matosmarco/SCDTR-Project/Fase1/Data_treatment/Images/caixa_2.jpg

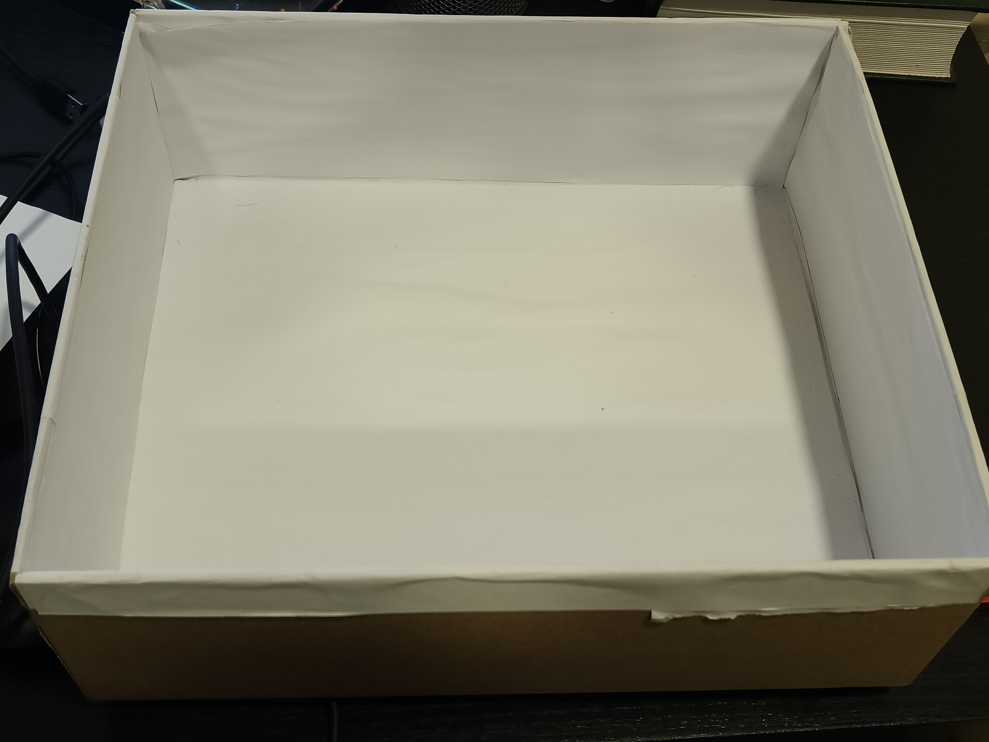
Fase1/Data_treatment/Images/caixa_2.jpg
