matosmarco/SCDTR-Project/Fase1/Data_treatment/Images/IMG20260316221124.jpg

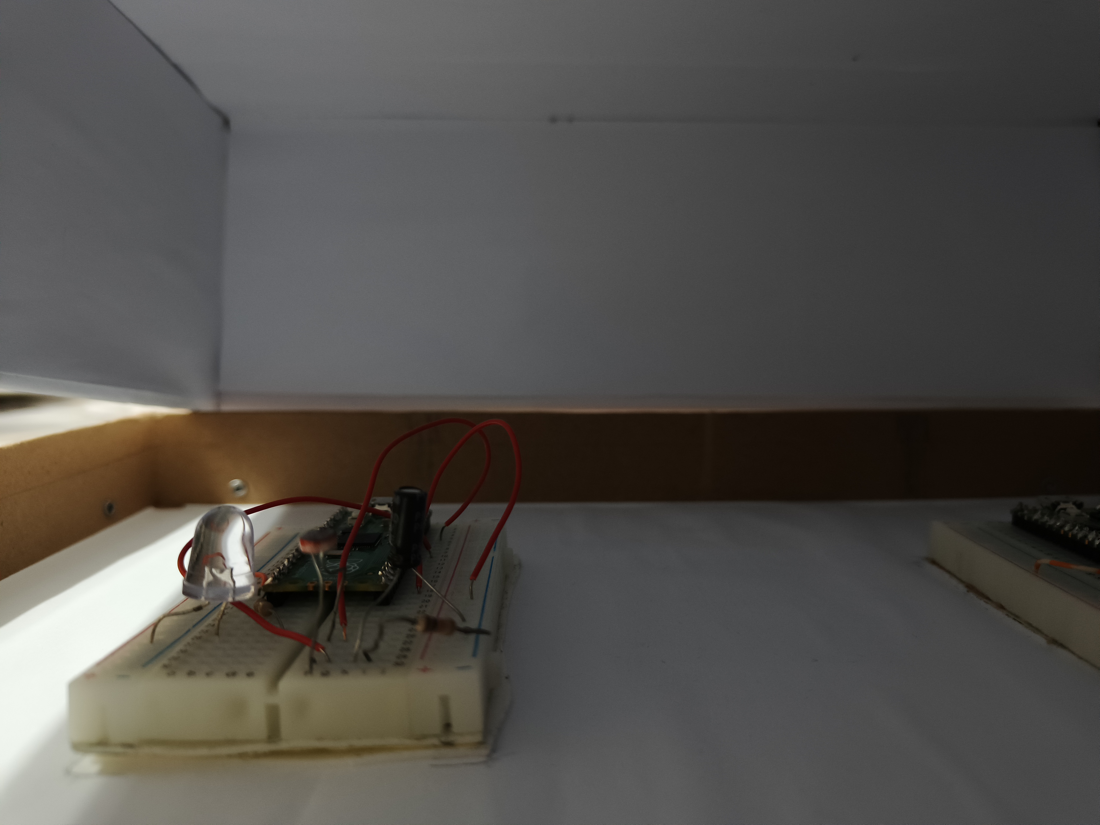
Fase1/Data_treatment/Images/IMG20260316221124.jpg
