matosmarco/SCDTR-Project/Fase1/Data_treatment/Images/stair.pdf

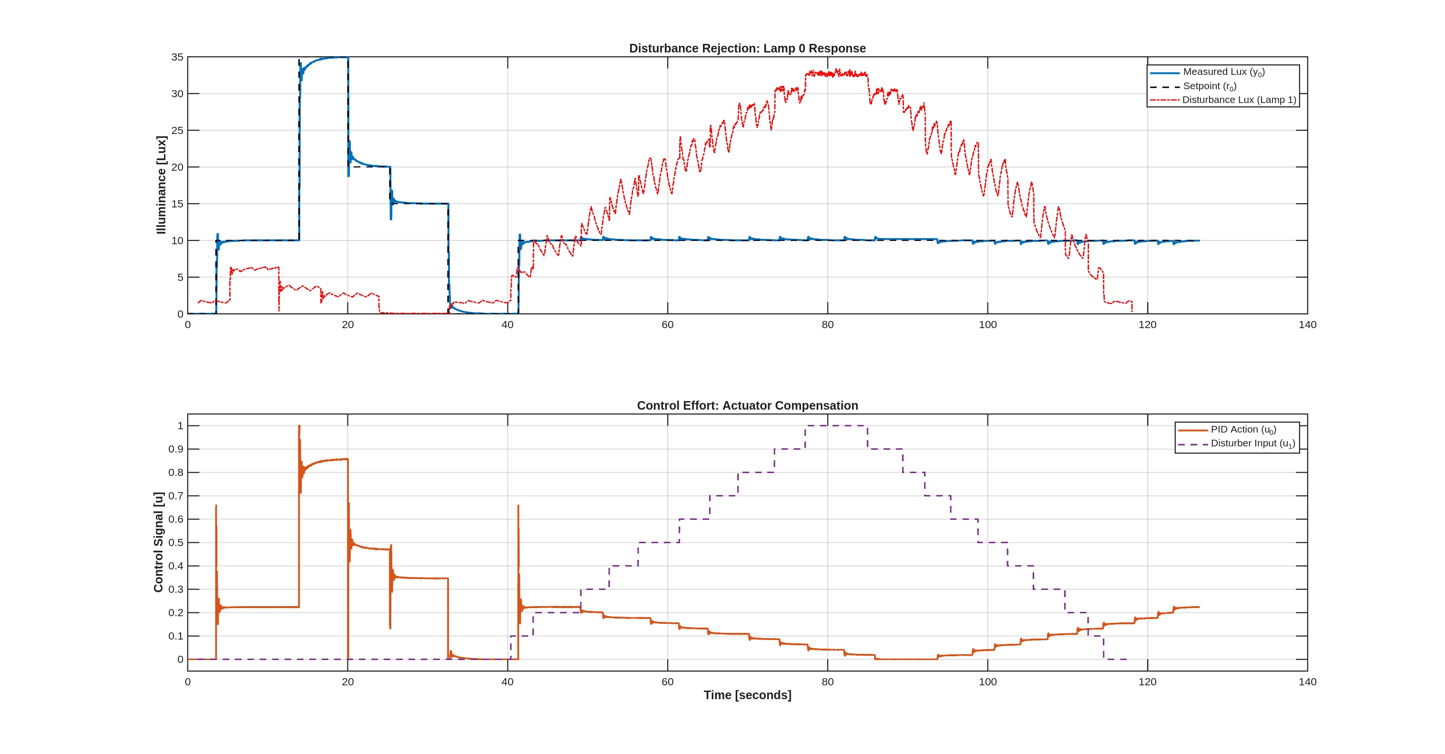
[picture p8: page 1]
