matosmarco/SCDTR-Project/Fase1/Data_treatment/Images/non_linear.pdf

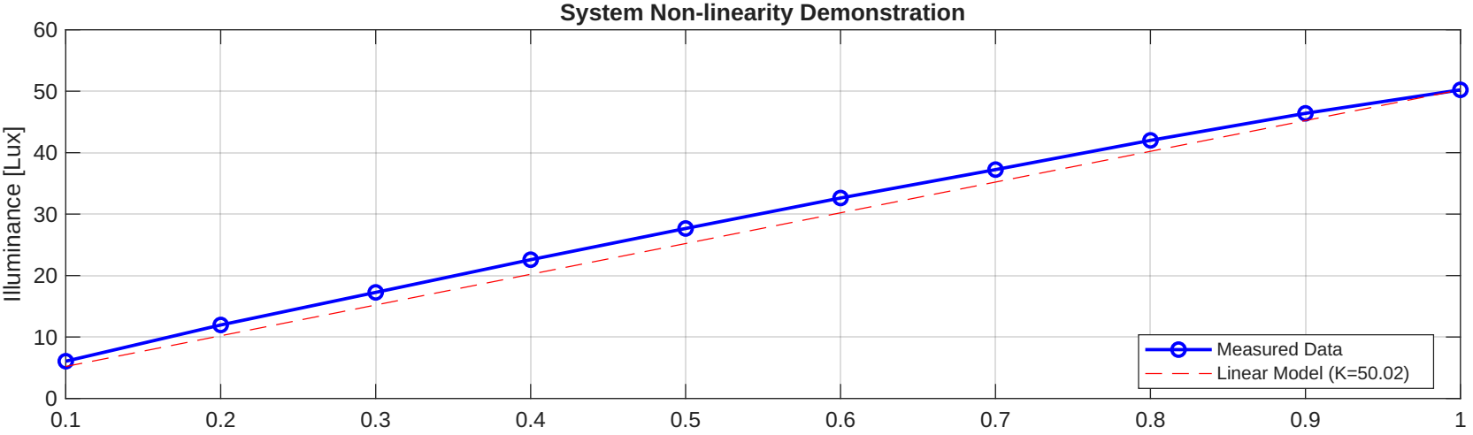
[picture p9: figure]
Illu; min; System Non-linearity Demonstration; Measured Data Linear Model (K=50.02)
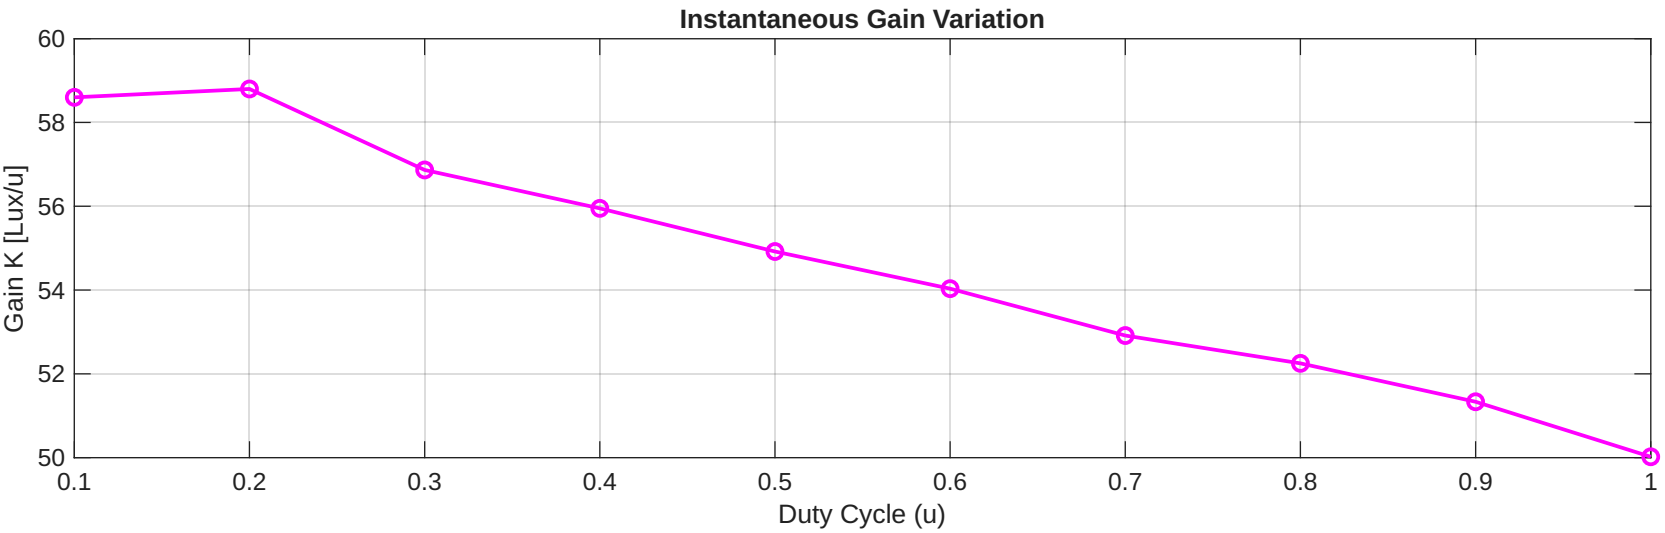
[picture p10: figure]
Duty Cycle (u); ain; Instantaneous Gain Variation
