matosmarco/SCDTR-Project/Fase1/Data_treatment/calib_m.png

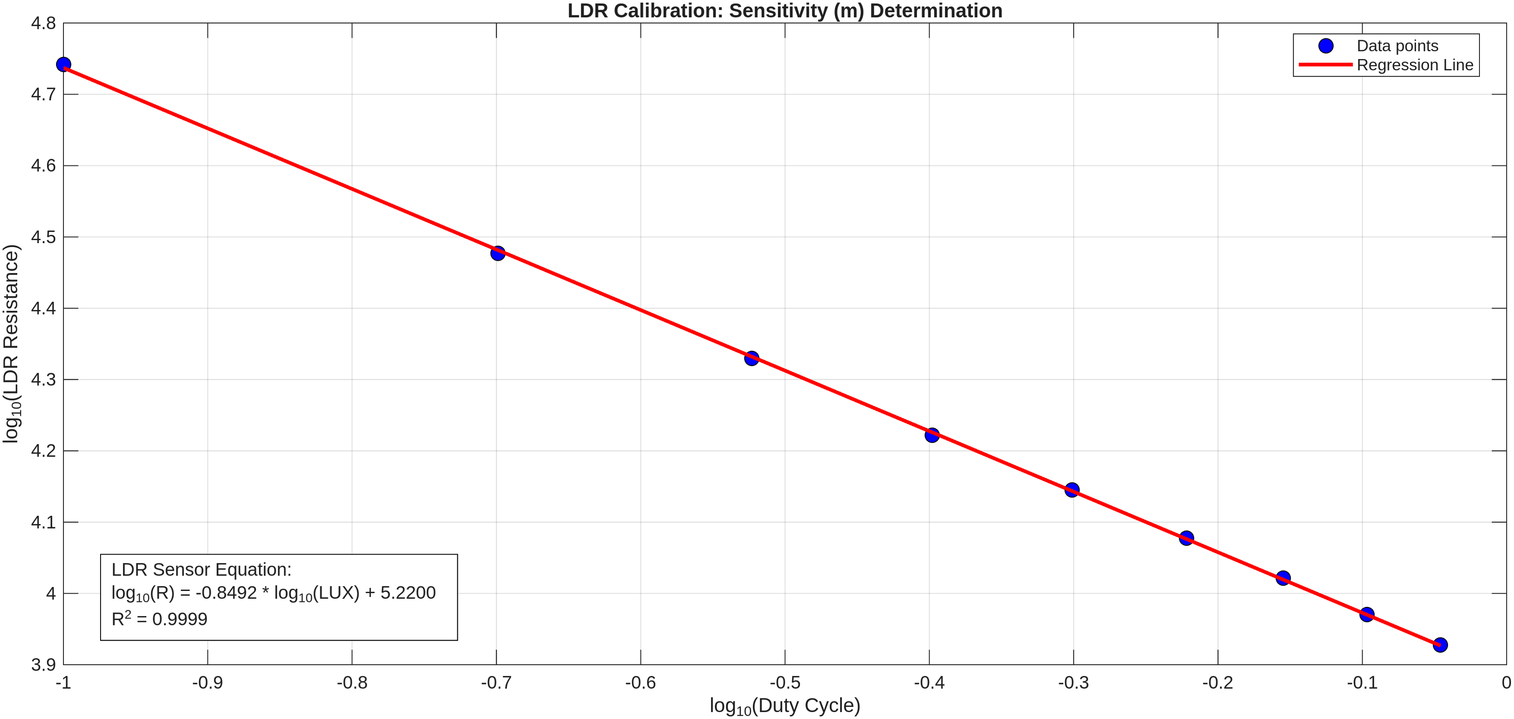
Fase1/Data_treatment/calib_m.png
