matosmarco/SCDTR-Project/Fase1/Data_treatment/comparison/final_kp_comparison.png

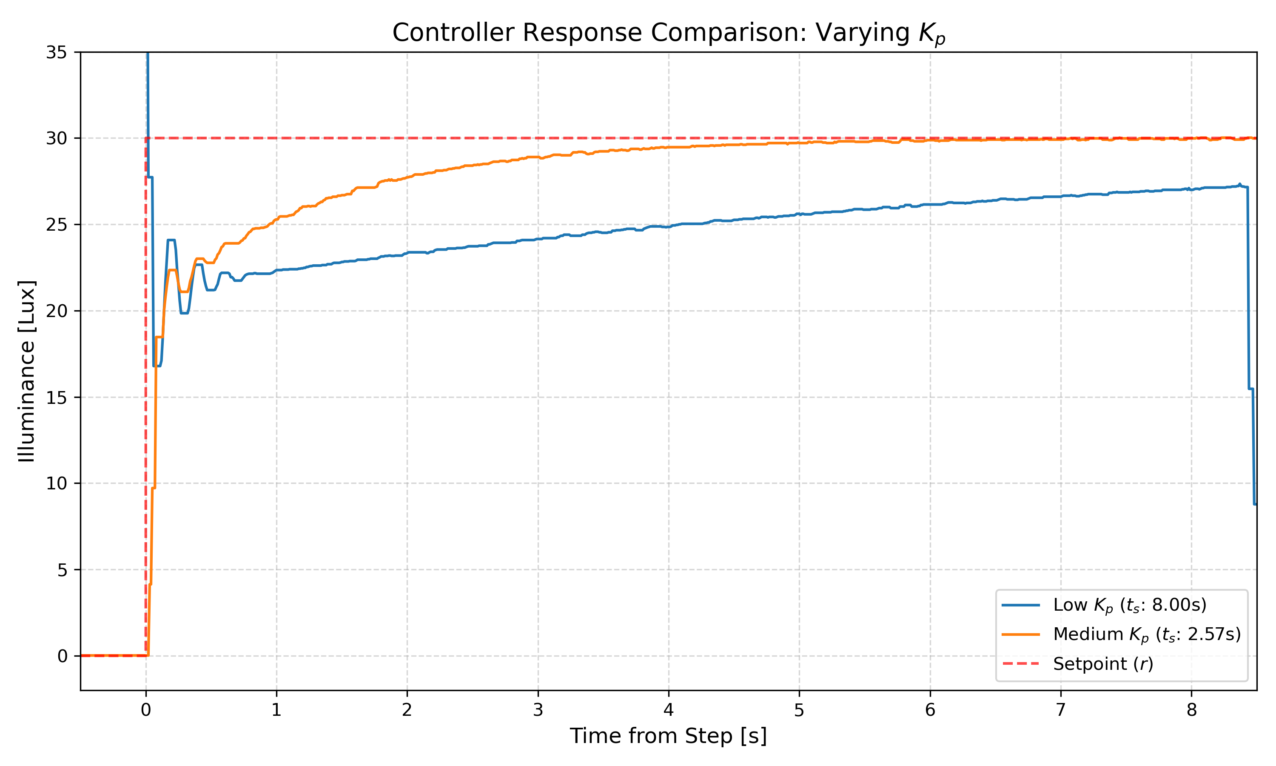
Fase1/Data_treatment/comparison/final_kp_comparison.png
