matosmarco/SCDTR-Project/Fase1/Data_treatment/comparison/setpoint_weighting_comparison.png

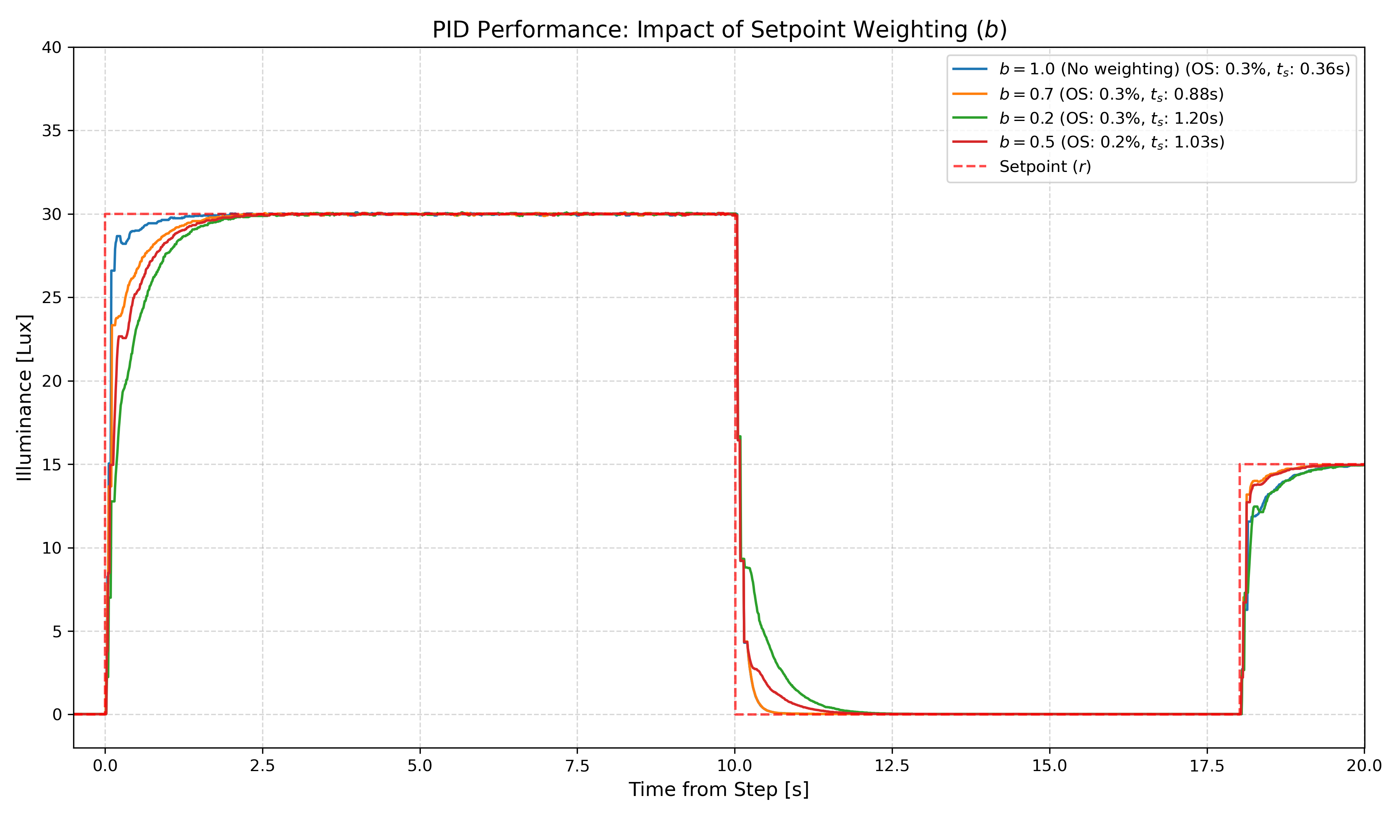
Fase1/Data_treatment/comparison/setpoint_weighting_comparison.png
