matosmarco/SCDTR-Project/Fase1/Data_treatment/comparison/vairos_ki.png

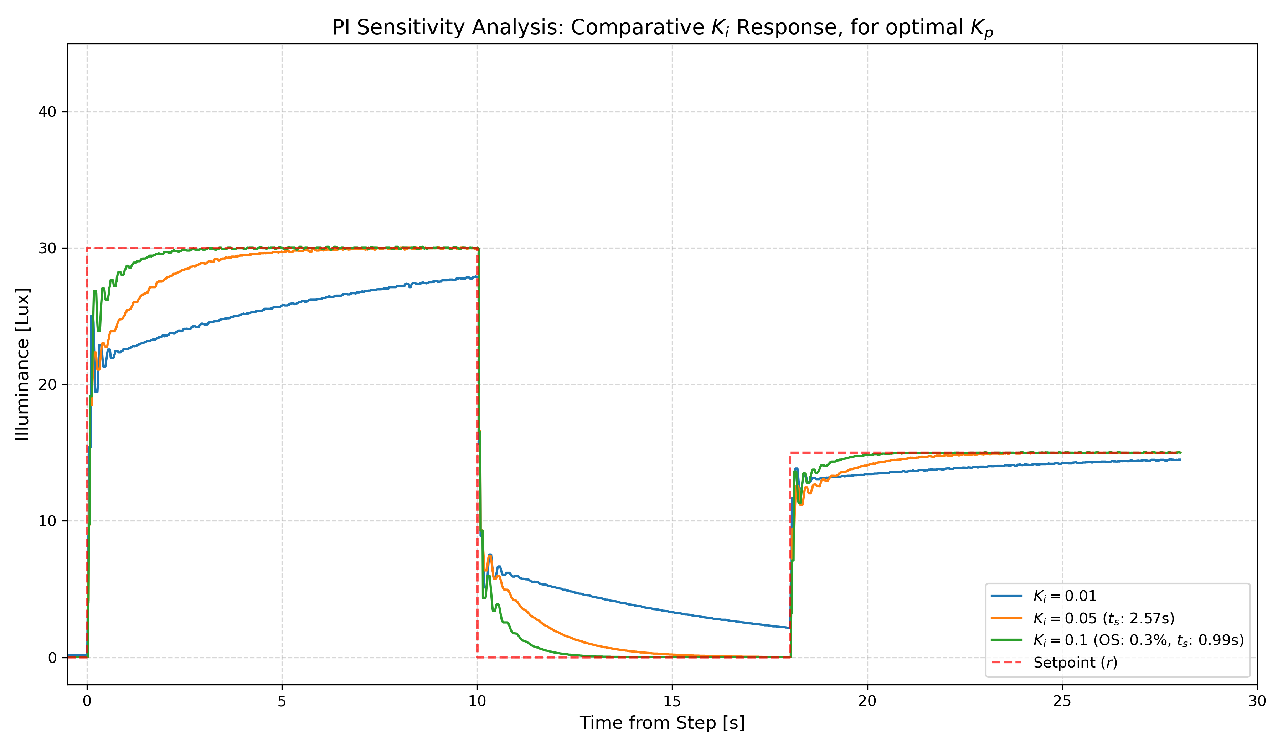
Fase1/Data_treatment/comparison/vairos_ki.png
