matosmarco/SCDTR-Project/Fase1/Data_treatment/comparison/varios_kp.png

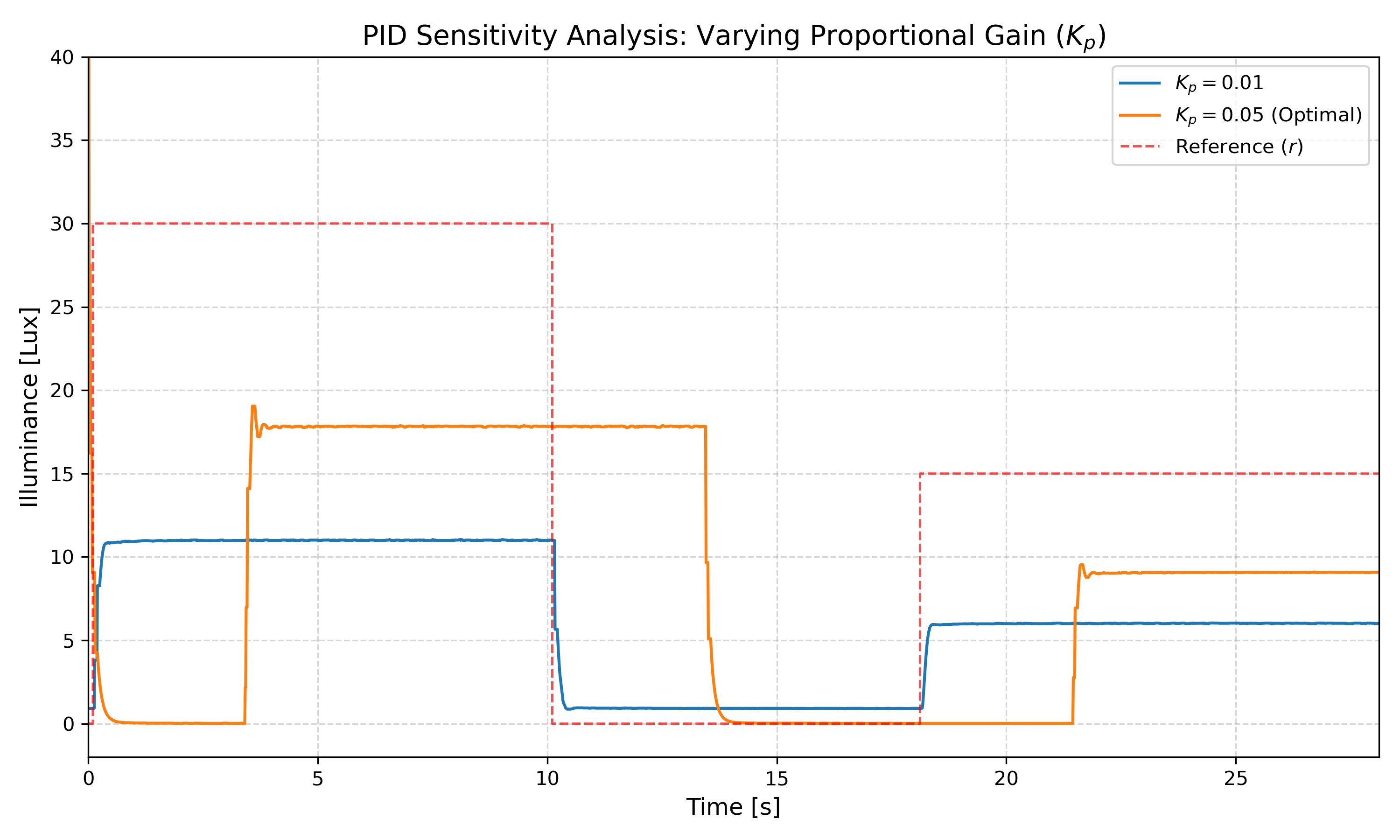
Fase1/Data_treatment/comparison/varios_kp.png
