matosmarco/SCDTR-Project/Fase1/Data_treatment/Images/caixa_1.jpg

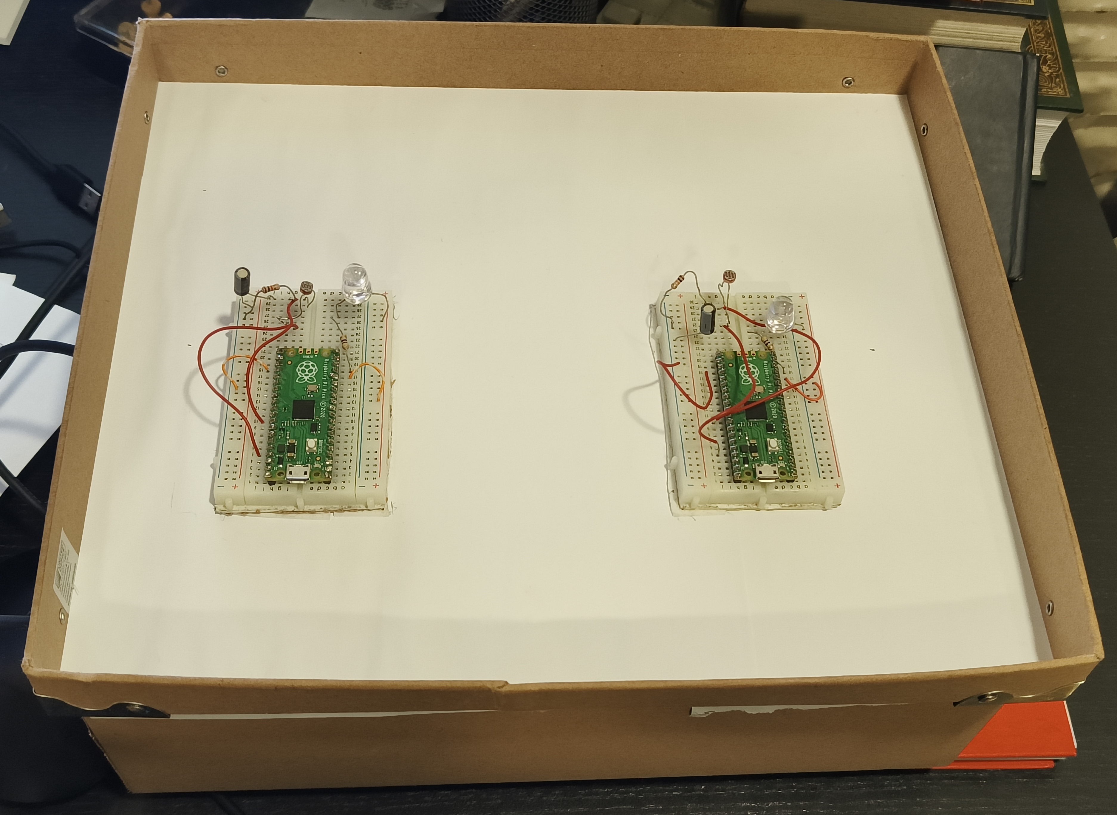
Fase1/Data_treatment/Images/caixa_1.jpg
