matosmarco/SCDTR-Project/Fase1/Data_treatment/Images/caixa_4.jpg

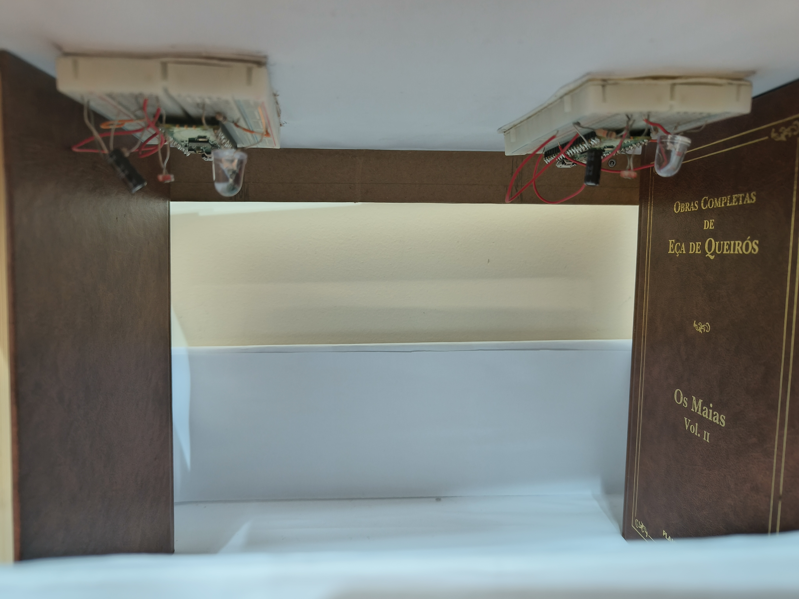
Fase1/Data_treatment/Images/caixa_4.jpg
