matosmarco/SCDTR-Project/Fase1/Data_treatment/Images/Luminaire positions.jpg

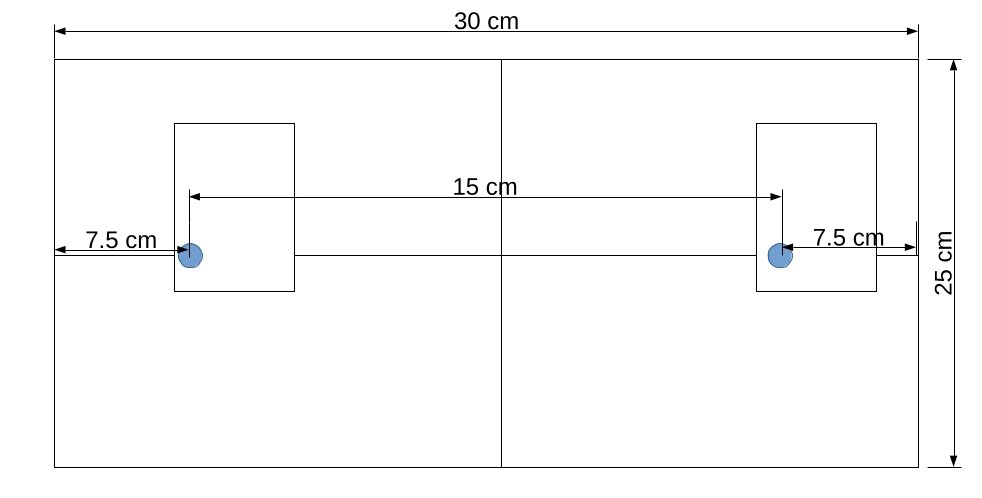
Fase1/Data_treatment/Images/Luminaire positions.jpg
