matosmarco/SCDTR-Project/Fase1/Data_treatment/Images/table1.png

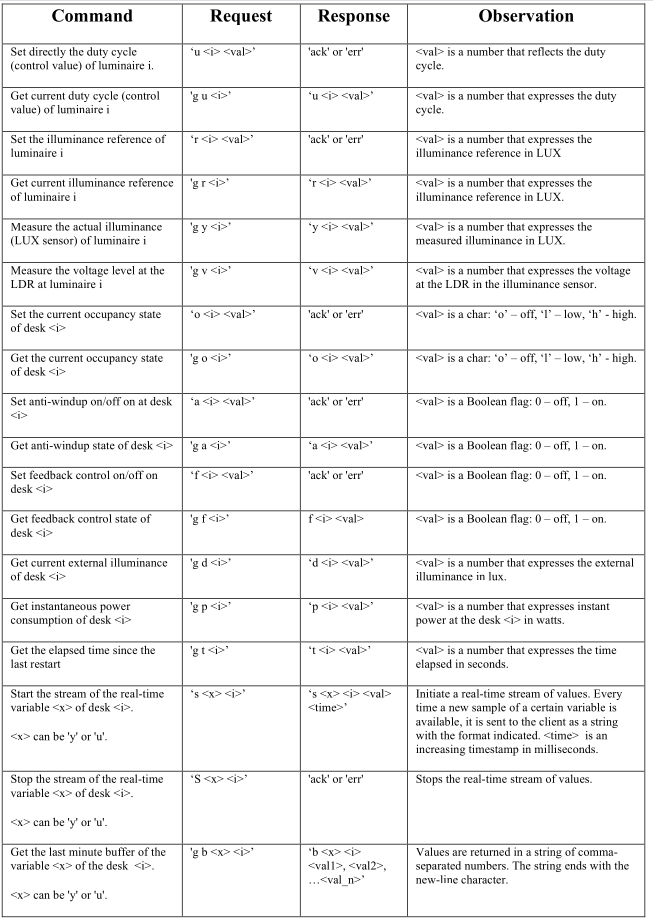
Fase1/Data_treatment/Images/table1.png
