matosmarco/SCDTR-Project/Fase1/Data_treatment/Images/table2.png

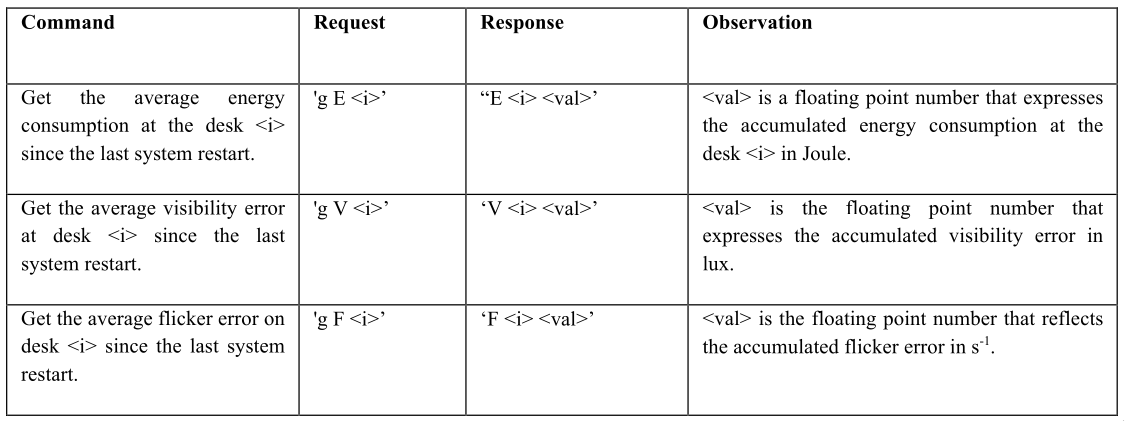
Fase1/Data_treatment/Images/table2.png
