matosmarco/SCDTR-Project/Fase1/Data_treatment/simulator.png

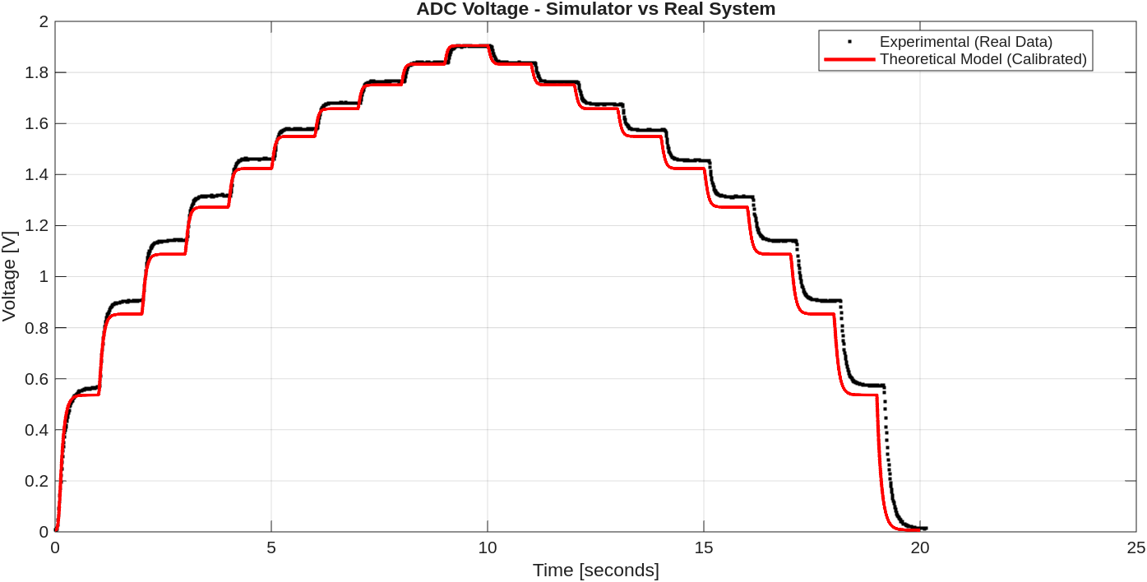
Fase1/Data_treatment/simulator.png
