matosmarco/SCDTR-Project/Fase1/Data_treatment/tau.png

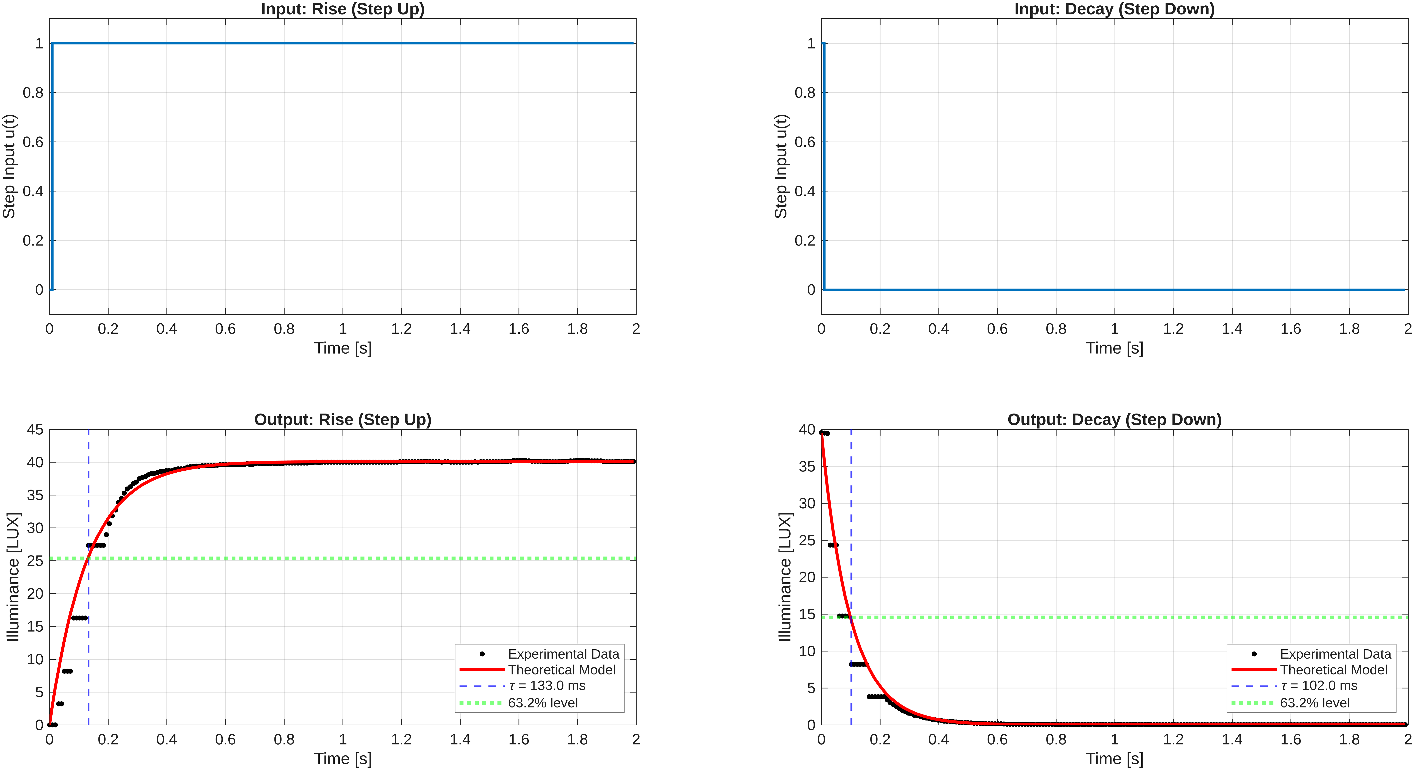
Fase1/Data_treatment/tau.png
