matosmarco/SCDTR-Project/Project/Info/LAB1-FIRST-STEPS.pdf

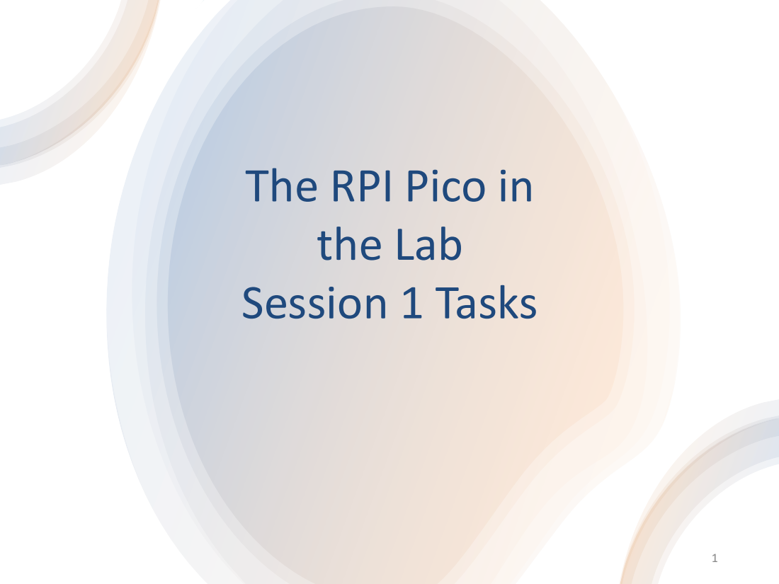
[picture p23: page 1]

The RPI Pico in
the Lab
Session 1 Tasks

# Session 1 Lab Tasks Install Software

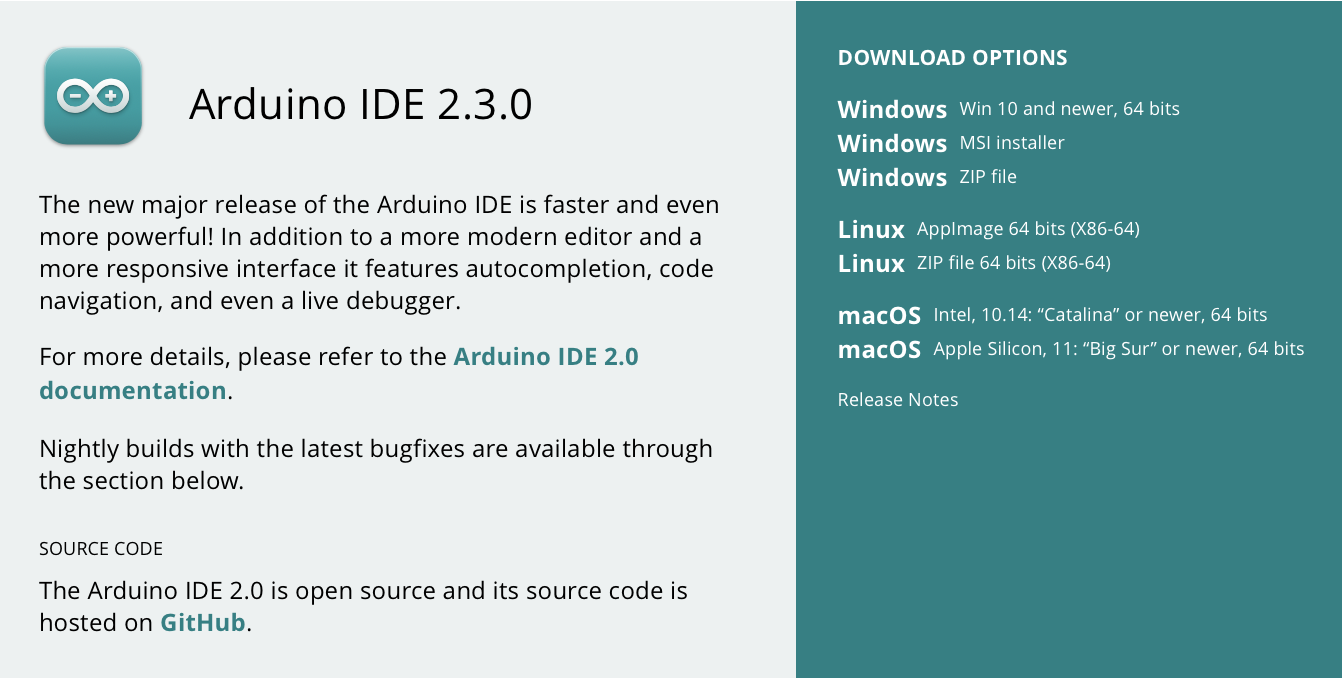
[picture p24: figure]

## Arduino IDE https://www.arduino.cc/en/software

## Arduino-core for RPI Pico Installation https://arduino-pico.readthedocs.io/en/latest/

# Session 1 Lab Tasks

# Write your first RPI pico program

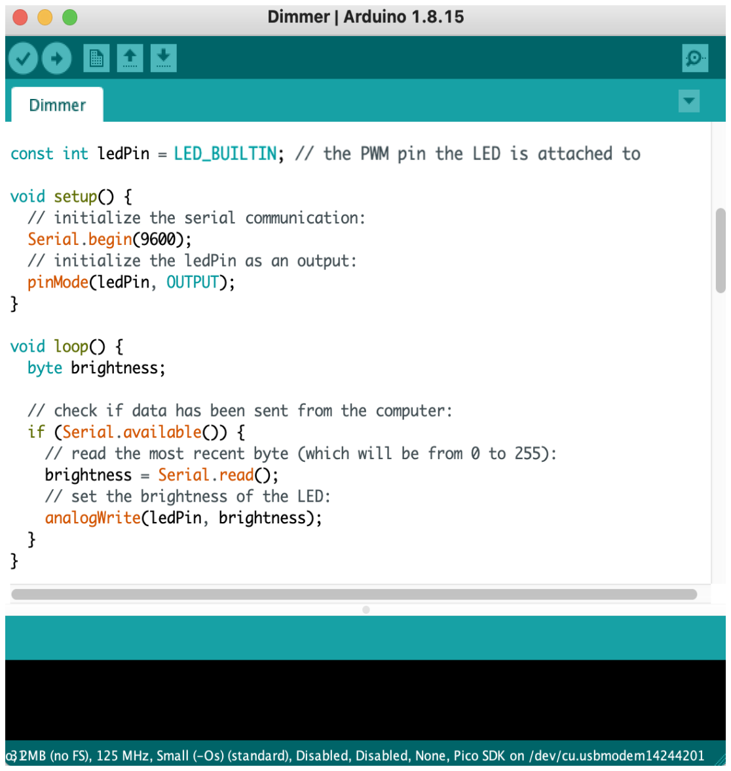
[picture p25: figure]

# - Look at menu “File/Examples”. Try out some sketches that use serial comms between PC and pico to become familiar with the programming environment, e.g. Dimmer

and Temperature.

# Session 1 Lab Tasks Load Firmware

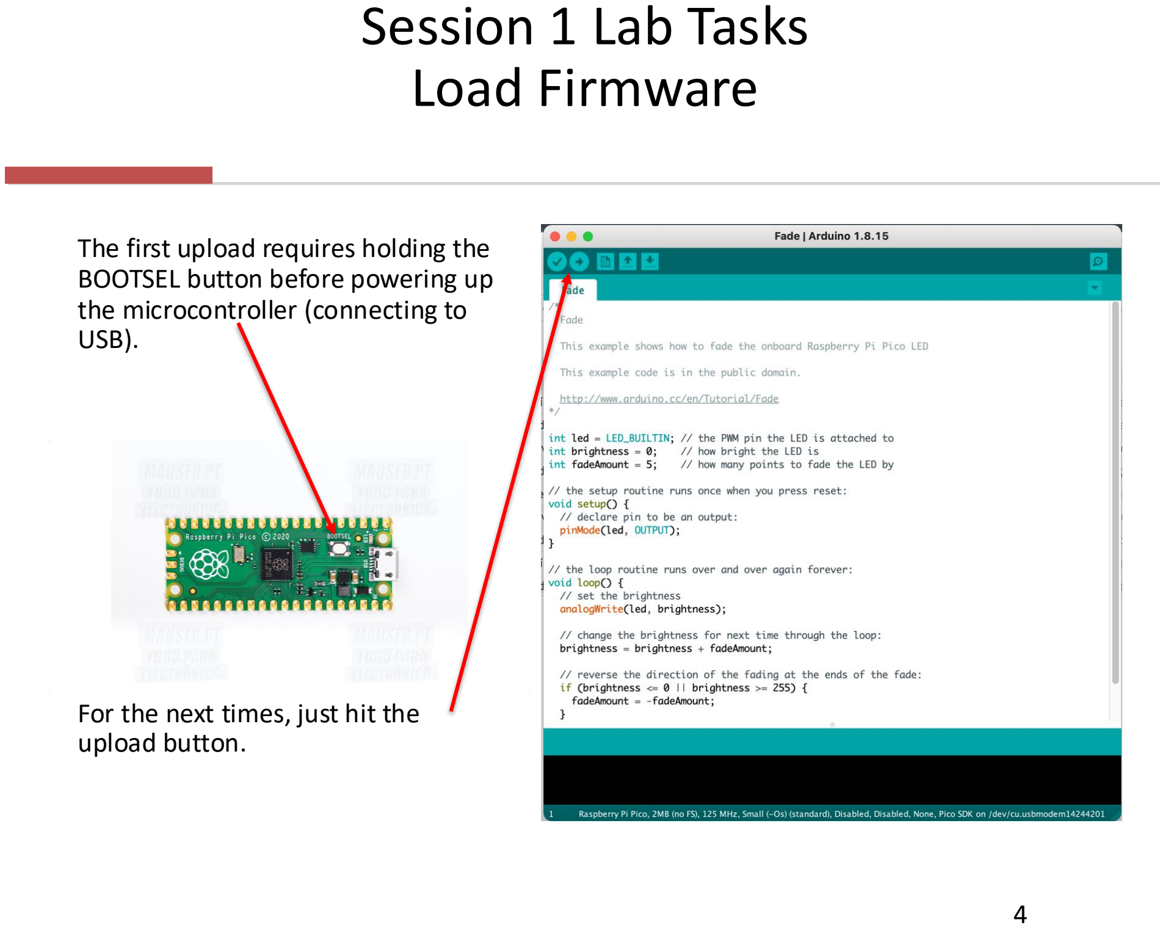
[picture p26: page 4]

## The first upload requires holding the BOOTSEL button before powering up the microcontroller (connecting to

USB).

## For the next times, just hit the

upload button.

# Week 1 Lab Tasks

# Serial USB Interface

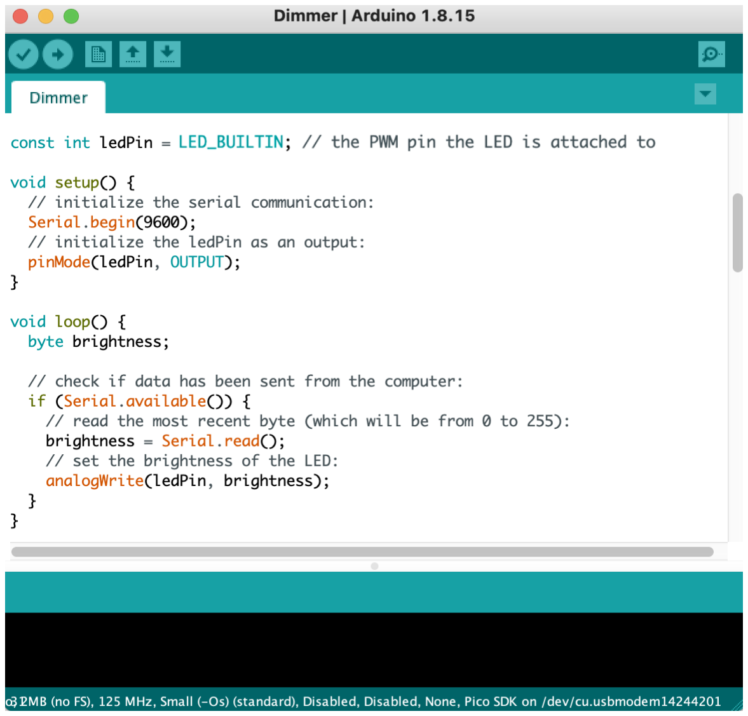
[picture p27: figure]

# - Look at some exemples that use serial communication between PC and pico, e.g. Dimmer

and Temperature.

# Session 1 Lab Tasks

# Serial USB Interface

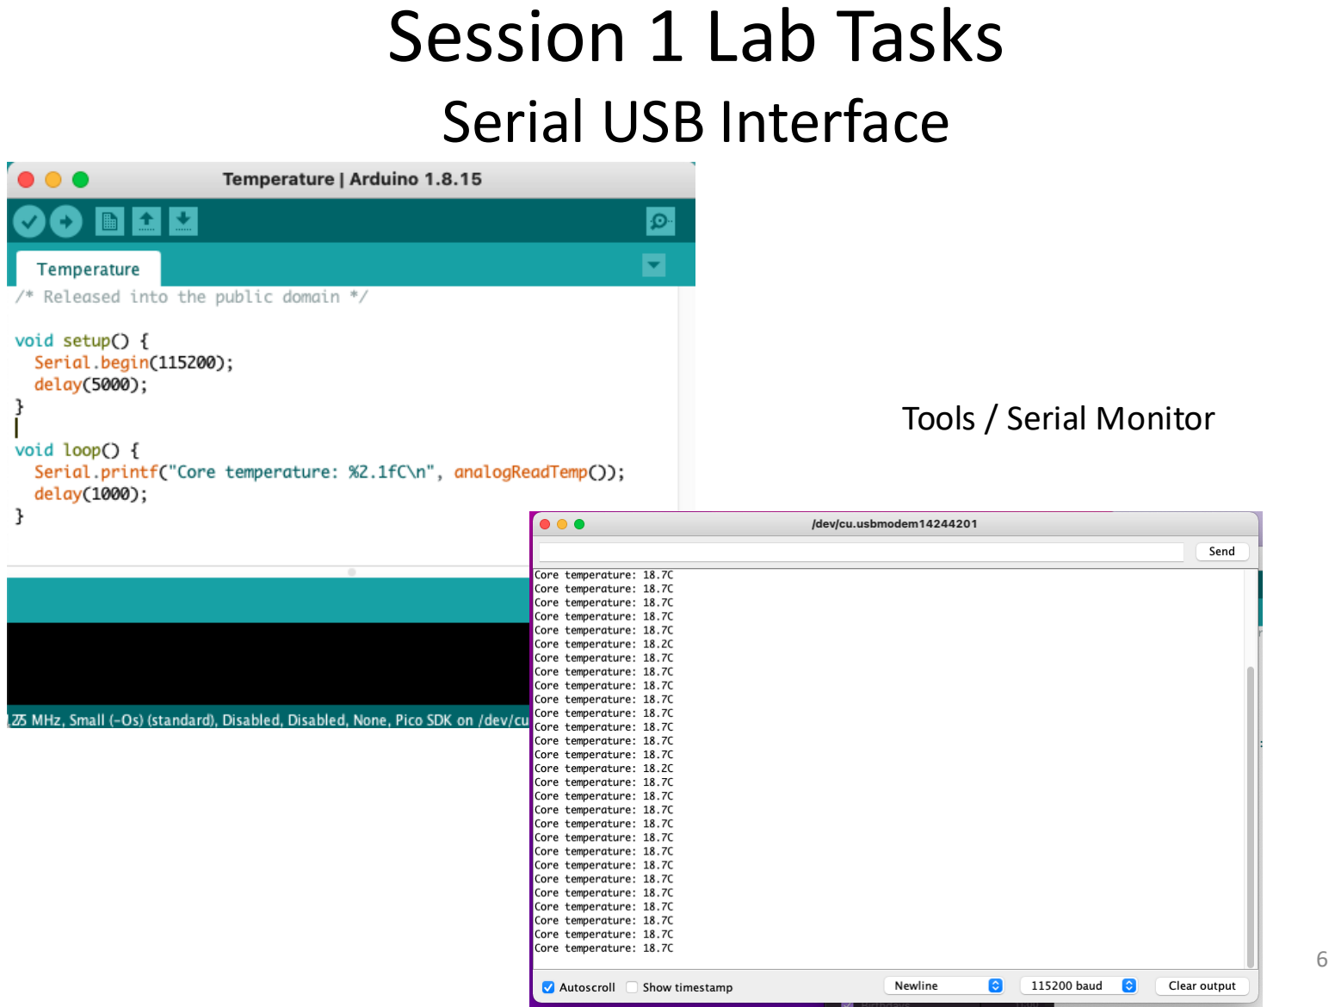
[picture p28: page 6]

# Tools / Serial Monitor

# Session Lab Tasks

# Prepare the Pico

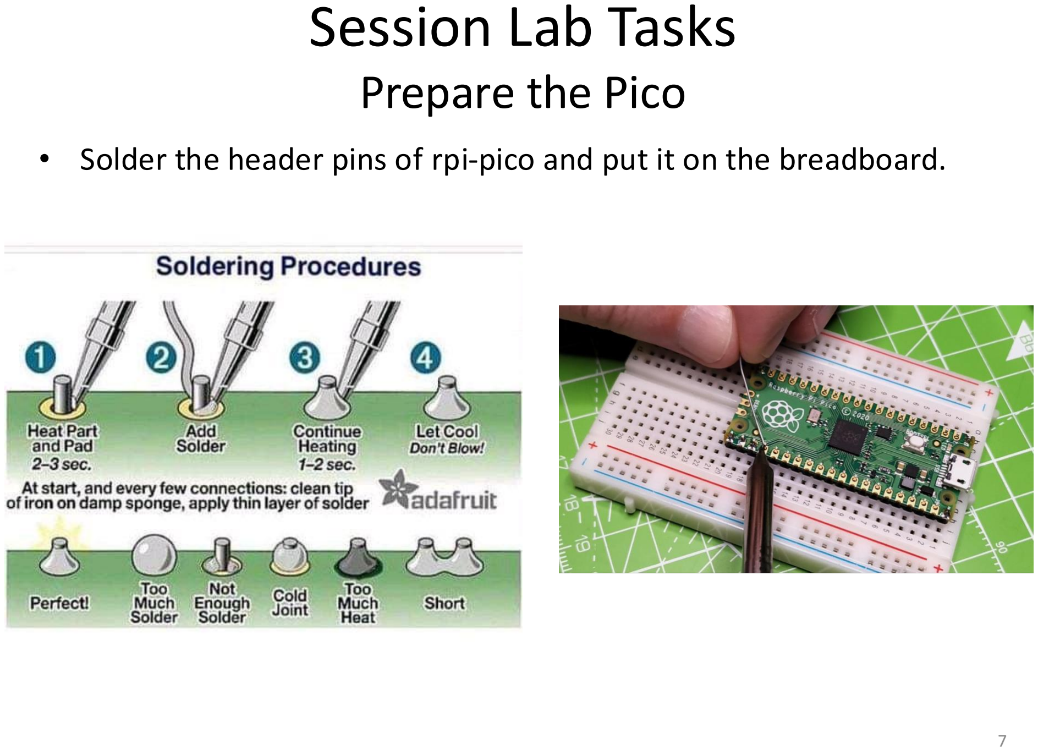
[picture p29: page 7]

- Solder the header pins of rpi-pico and put it on the breadboard.

# Session 1 Lab Tasks

# Assemble the Breadboard Components

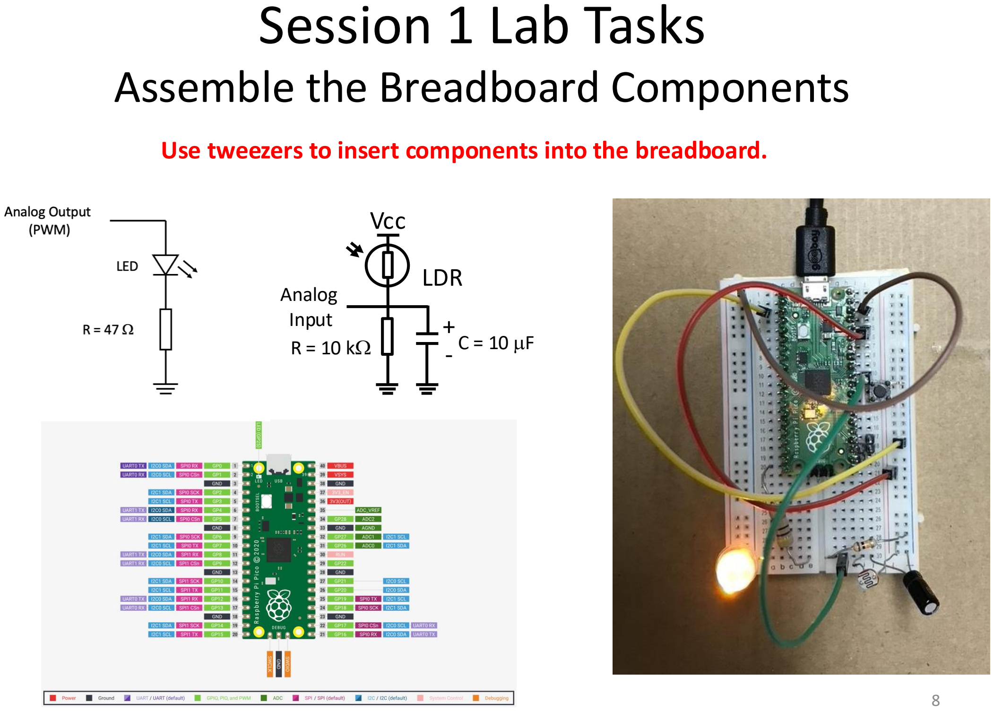
[picture p30: page 8]

# Vcc

# LDR

## Analog

Input | +
R = 10 kΩ | C = 10 µF

Use tweezers to insert components into the breadboard.

# Session 1 Lab Tasks

# Basic IO

const int LED_PIN = 15;

const int DAC_RANGE = 4096;

int counter = 0;

void setup() {// the setup function runs once

Serial.begin(115200);

analogReadResolution(12); //default is 10

analogWriteFreq(60000); //60KHz, about max

analogWriteRange(DAC_RANGE); //100% duty cycle

}

void loop() {// the loop function runs cyclically

int read_adc;

analogWrite(LED_PIN, counter); // set led PWM

delay(1); | //delay 1ms

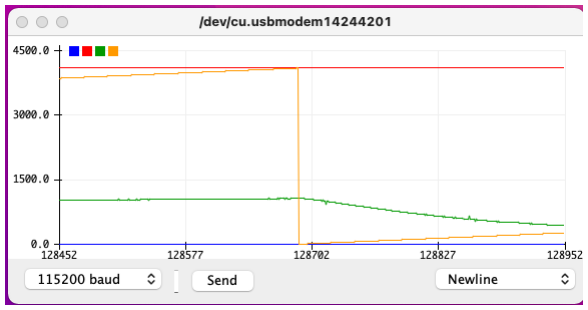
[picture p31: figure]

read_adc = analogRead(A0); // read analog voltage

counter = counter + 1;

if (counter > DAC_RANGE) // if counter saturates

counter = 0; | // reset counter

//format that Serial Plotter likes

Serial.print(0); Serial.print(" ");

Serial.print(DAC_RANGE); Serial.print(" ");

Serial.print(read_adc); Serial.print(" ");

Serial.print(counter); Serial.println();

}

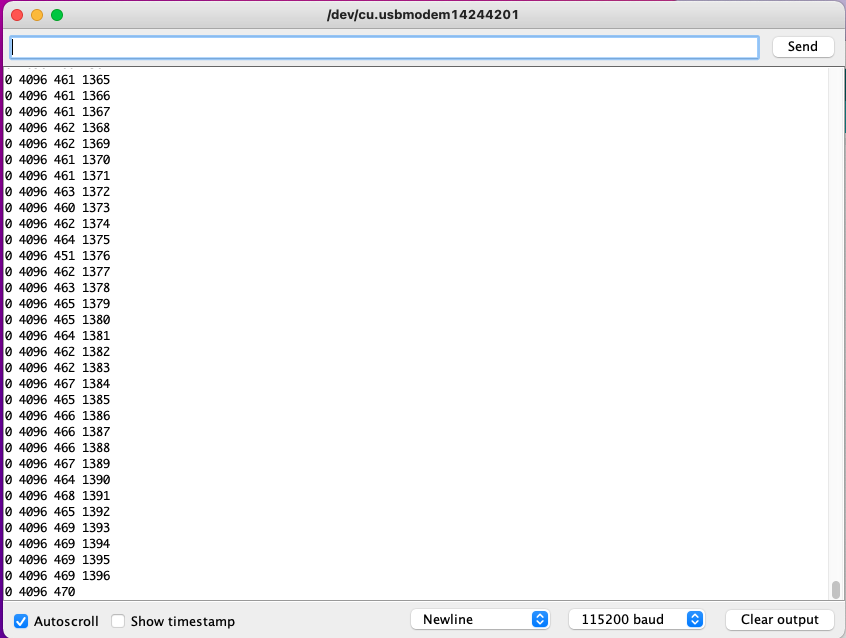
[picture p32: figure]

# Serial Plotter

# Serial Monitor
