matosmarco/SCDTR-Project/Fase1/Data_treatment/PID/results_kp005.txt

s b 0 1.78 0.0413 0.00 207924
s b 0 1.77 0.0416 0.00 207934
s b 0 1.77 0.0416 0.00 207944
s b 0 1.77 0.0416 0.00 207954
s b 0 1.77 0.0416 0.00 207964
s b 0 1.77 0.0416 0.00 207974
s b 0 1.77 0.0416 0.00 207984
s b 0 1.76 0.0419 0.00 207994
s b 0 1.77 0.0416 0.00 208004
s b 0 1.77 0.0416 0.00 208014
s b 0 1.77 0.0416 0.00 208024
s b 0 1.78 0.0413 0.00 208034
s b 0 1.78 0.0413 0.00 208044
s b 0 1.78 0.0410 0.00 208054
s b 0 1.78 0.0410 0.00 208064
s b 0 1.78 0.0413 0.00 208074
s b 0 1.78 0.0413 0.00 208084
s b 0 1.78 0.0413 0.00 208094
s b 0 1.78 0.0413 0.00 208104
s b 0 1.78 0.0413 0.00 208114
s b 0 1.78 0.0413 0.00 208124
s b 0 1.77 0.0416 0.00 208134
s b 0 1.77 0.0416 0.00 208144
s b 0 1.76 0.0419 0.00 208154
s b 0 1.76 0.0419 0.00 208164
s b 0 1.76 0.0419 0.00 208174
s b 0 1.76 0.0419 0.00 208184
s b 0 1.76 0.0419 0.00 208194
s b 0 1.76 0.0422 0.00 208204
s b 0 1.76 0.0422 0.00 208214
s b 0 1.76 0.0422 0.00 208224
s b 0 1.76 0.0419 0.00 208234
s b 0 1.76 0.0419 0.00 208244
s b 0 1.77 0.0416 0.00 208254
s b 0 1.77 0.0416 0.00 208264
s b 0 1.78 0.0413 0.00 208274
s b 0 1.78 0.0413 0.00 208284
s b 0 1.78 0.0413 0.00 208294
s b 0 1.78 0.0410 0.00 208304
s b 0 1.78 0.0410 0.00 208314
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
ack
s b 0 1.78 0.5413 10.00 214234
s b 0 1.78 0.5413 10.00 214244
s b 0 1.78 0.5413 10.00 214254
s b 0 4.91 0.3846 10.00 214264
s b 0 4.91 0.3846 10.00 214274
s b 0 4.91 0.3846 10.00 214284
s b 0 4.91 0.3846 10.00 214294
s b 0 4.91 0.3846 10.00 214304
s b 0 9.34 0.1629 10.00 214314
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
s b 0 8.84 0.1881 10.00 232734
s b 0 8.79 0.1906 10.00 232744
s b 0 8.66 0.1969 10.00 232754
s b 0 8.61 0.1994 10.00 232764
s b 0 8.55 0.2026 10.00 232774
s b 0 8.45 0.2075 10.00 232784
s b 0 8.45 0.2075 10.00 232794
s b 0 8.44 0.2081 10.00 232804
s b 0 8.43 0.2087 10.00 232814
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
