matosmarco/SCDTR-Project/Fase1/Data_treatment/Images/bumpless.pdf

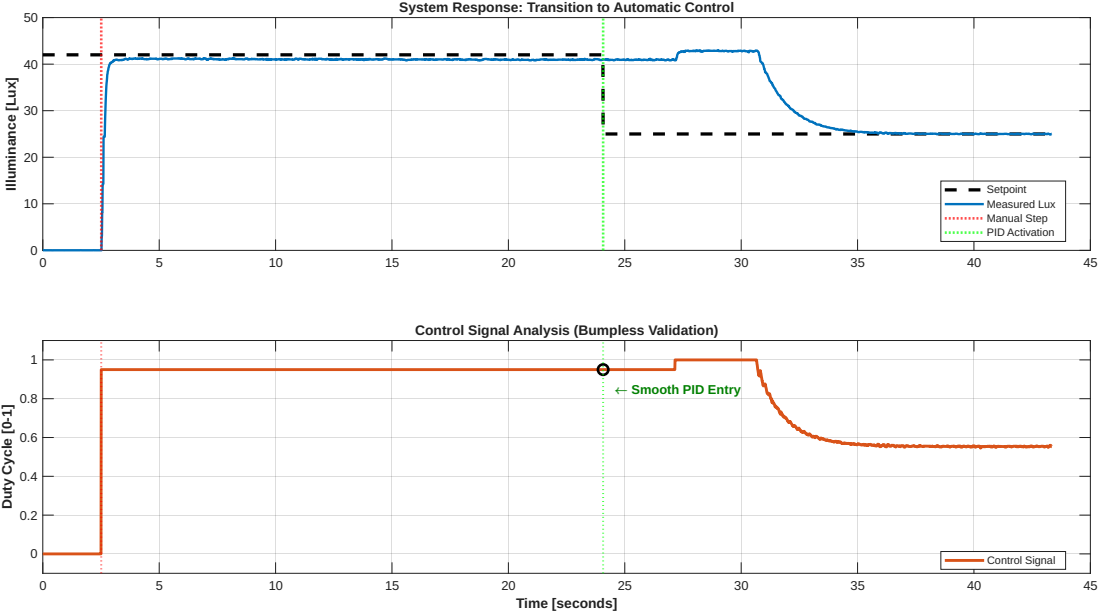
[picture p34: page 1]
Illuminance [Lux]; Duty Cycle [0-1]; ol Sig

S e t p oin t M e a s u r e d L u x

M a n u al S t e p PID A c tiv a tio n
