matosmarco/SCDTR-Project/Fase1/Data_treatment/Images/disturbance_more controled.pdf

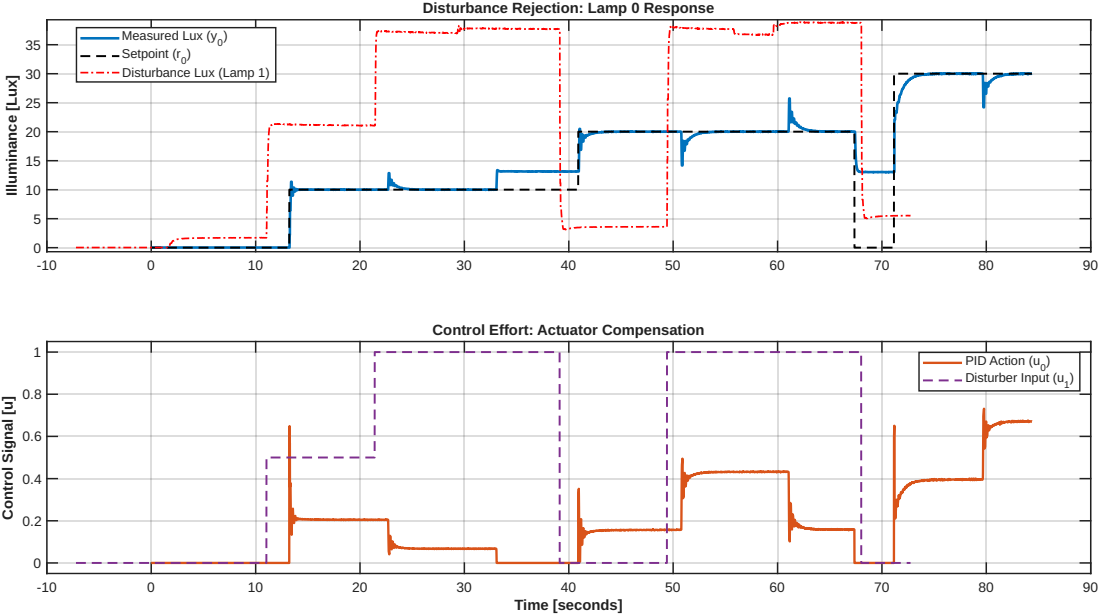
[picture p35: page 1]
Illuminance [Lux]; Control Signal [u]; PID; tio; Dis

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
