matosmarco/SCDTR-Project/Fase1/Data_treatment/Images/state_switching.pdf

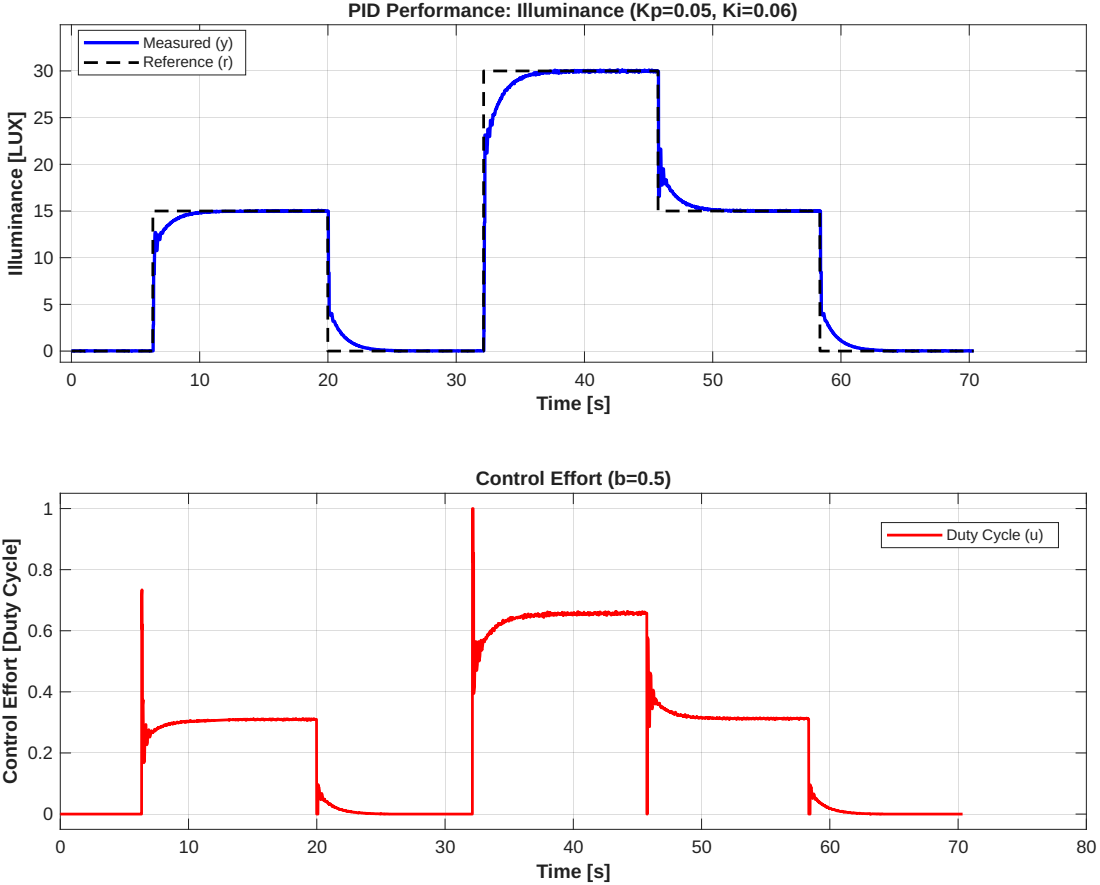
[picture p37: page 1]
Time [s]; Illu; min; Measured (y) Reference (r); ntrol Effort [D; uty; cle]; Control Effort (b=0.5); Duty Cycle (u)

PID Performance: Illuminance (Kp=0.05, Ki=0.06)
