matosmarco/SCDTR-Project/Fase1/Data_treatment/Images/disturbance_not_measured.pdf

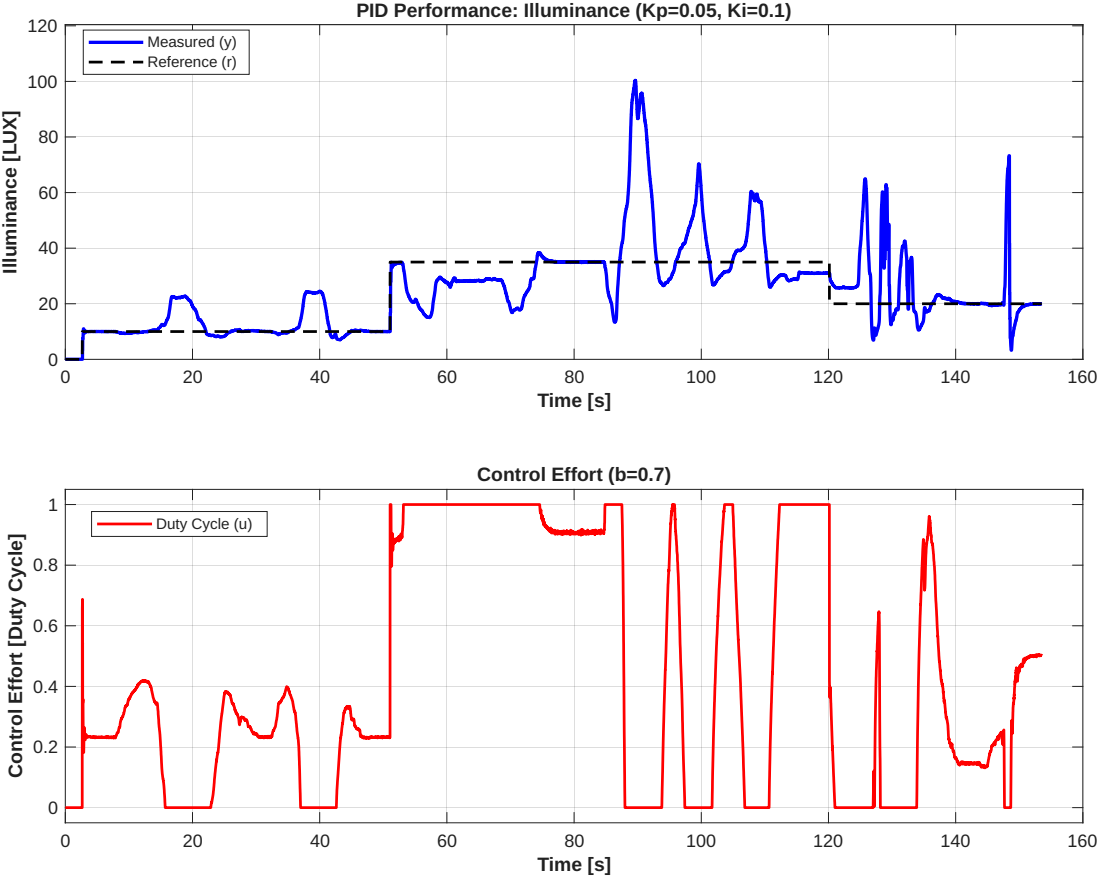
[picture p38: page 1]
Illuminance [LUX]; cle

Control Effort [Duty Cycle]
