matosmarco/SCDTR-Project/Fase1/Data_treatment/PID/param_tuning/Figures/no_ff_no_antiwindup/kp001.pdf

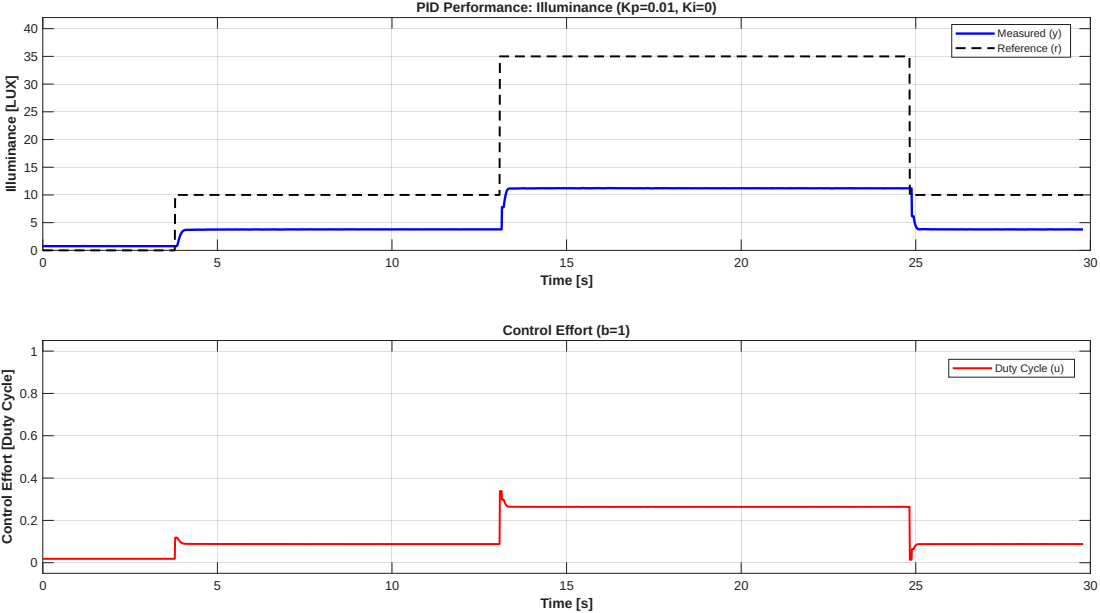
[picture p39: page 1]
Illuminance [LUX]; cle

Control Effort [Duty Cycle]
