matosmarco/SCDTR-Project/Fase1/Data_treatment/Images/kp005_only.pdf

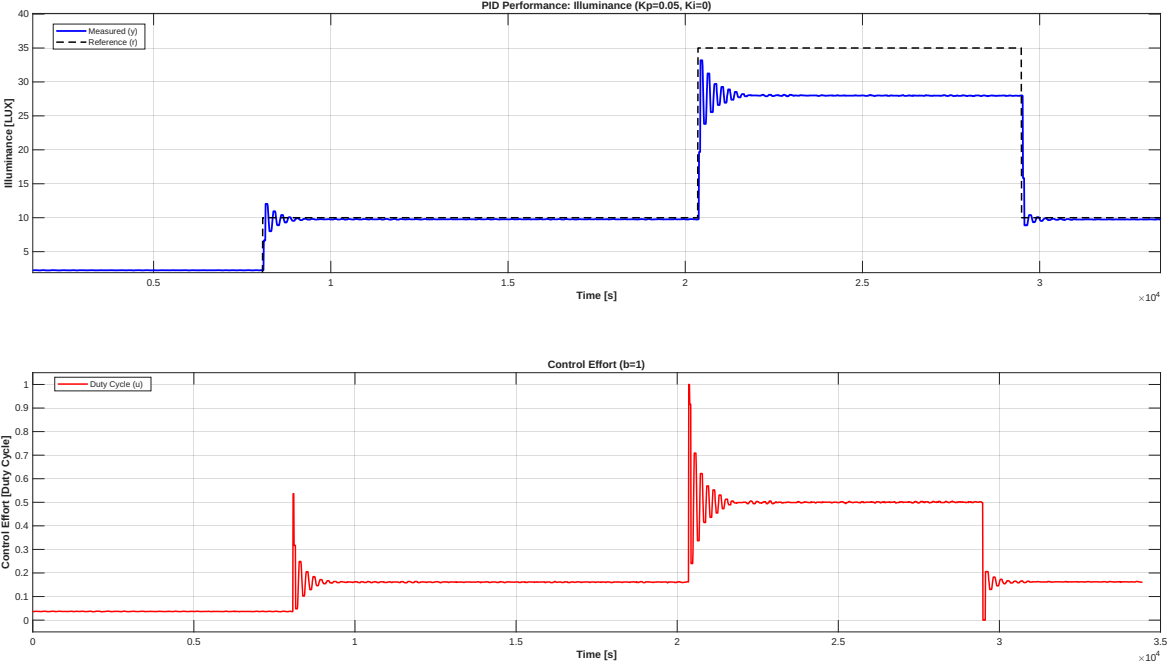
[picture p41: page 1]
Illuminance [LUX]; cle

Control Effort [Duty Cycle]
