matosmarco/SCDTR-Project/Fase1/Data_treatment/Images/jitter.pdf

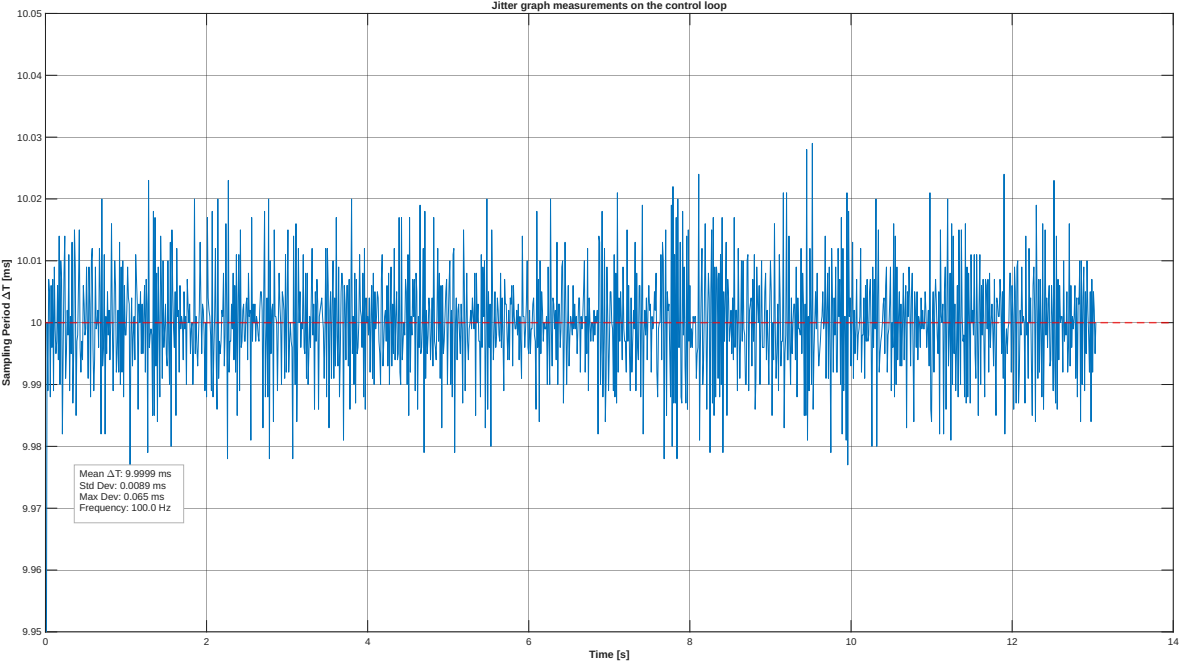
[picture p42: page 1]

Sampling Period "T [ms]
