matosmarco/SCDTR-Project/Fase1/Data_treatment/Images/kp005.pdf

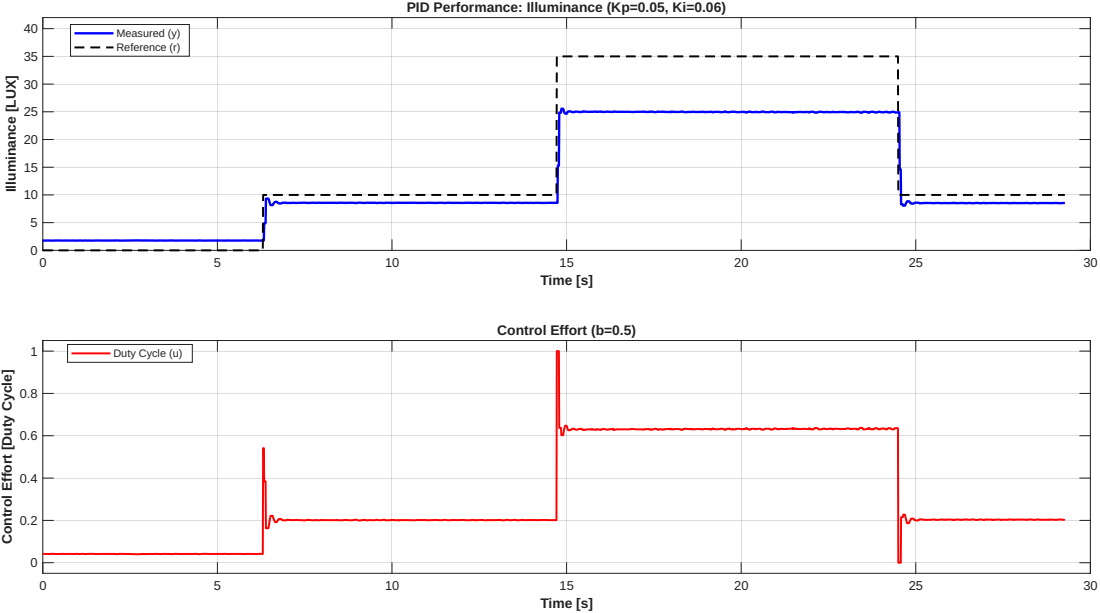
[picture p43: page 1]
Illuminance [LUX]; cle

Control Effort [Duty Cycle]
