matosmarco/SCDTR-Project/Fase1/Data_treatment/Images/kp005_ki001.pdf

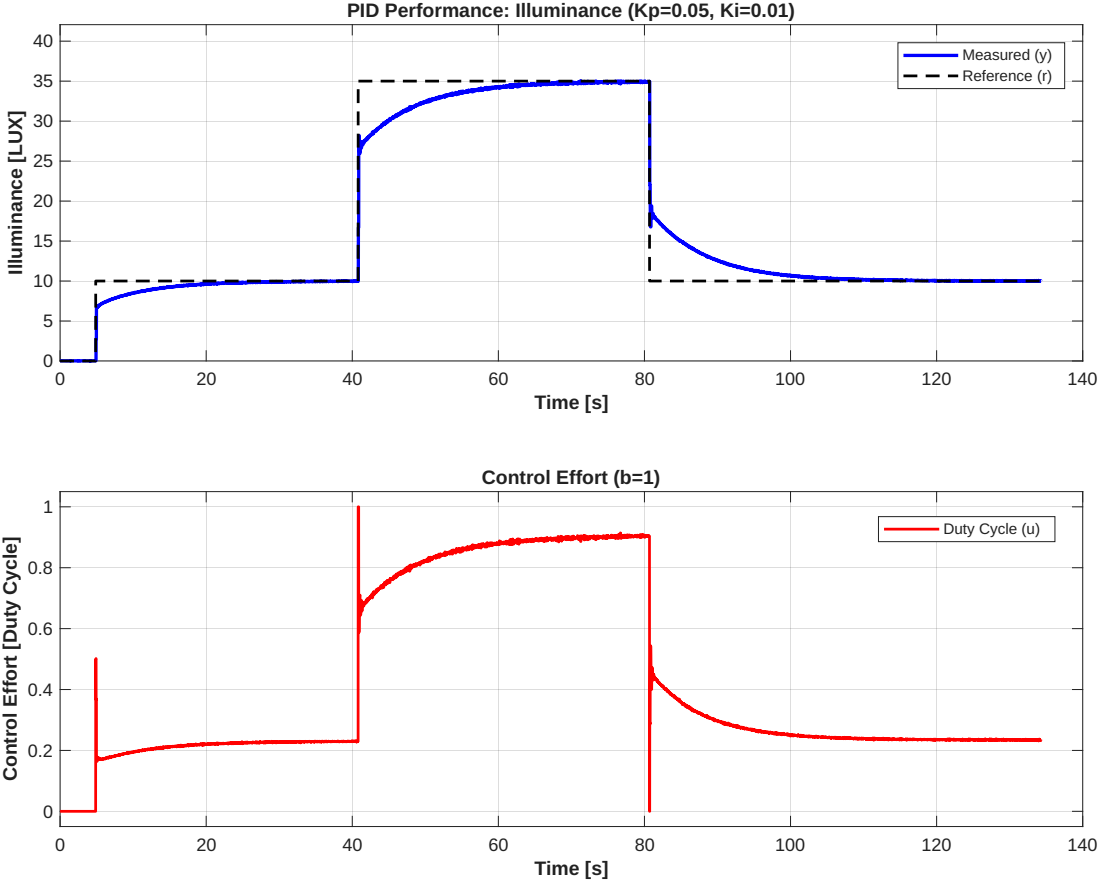
[picture p44: page 1]
Illuminance [LUX]; cle

Control Effort [Duty Cycle]
