matosmarco/SCDTR-Project/Fase1/Data_treatment/Images/kp005_ki005.pdf

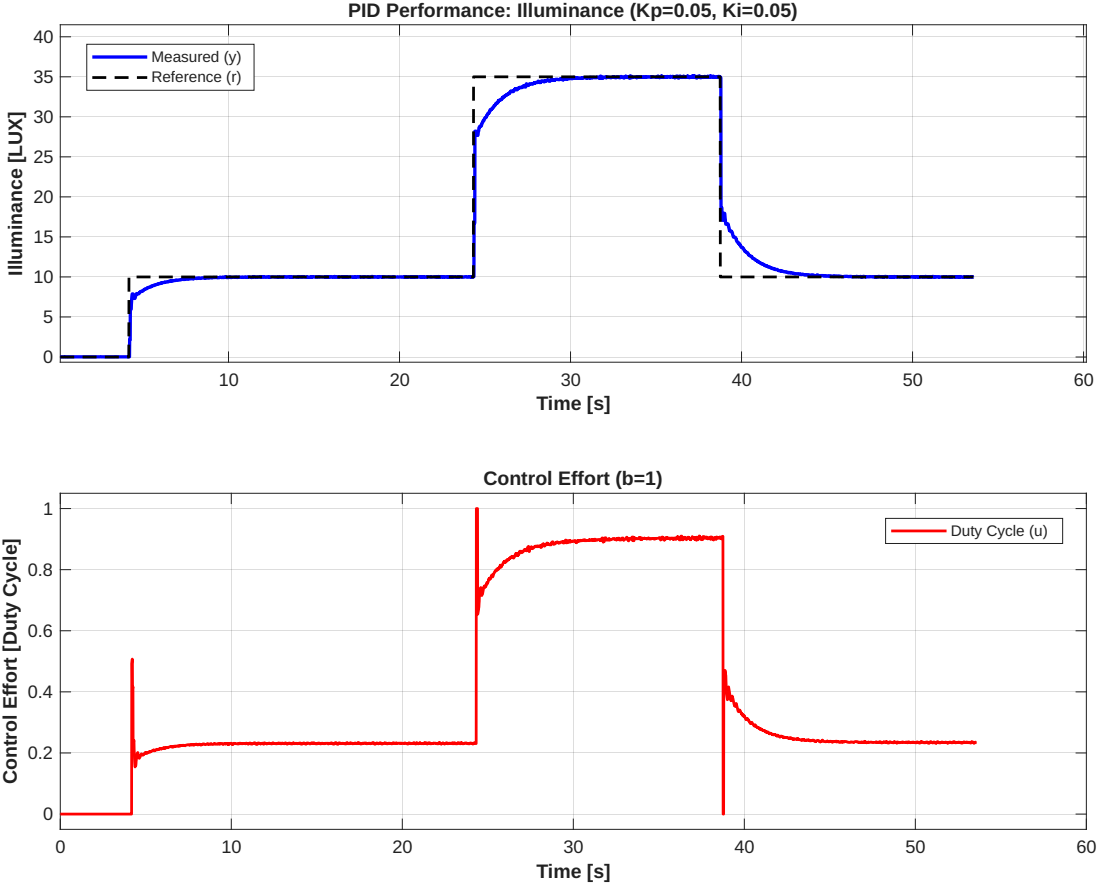
[picture p45: page 1]
Illuminance [LUX]; cle

Control Effort [Duty Cycle]
