matosmarco/SCDTR-Project/Fase1/Data_treatment/Images/kp005_ki01.pdf

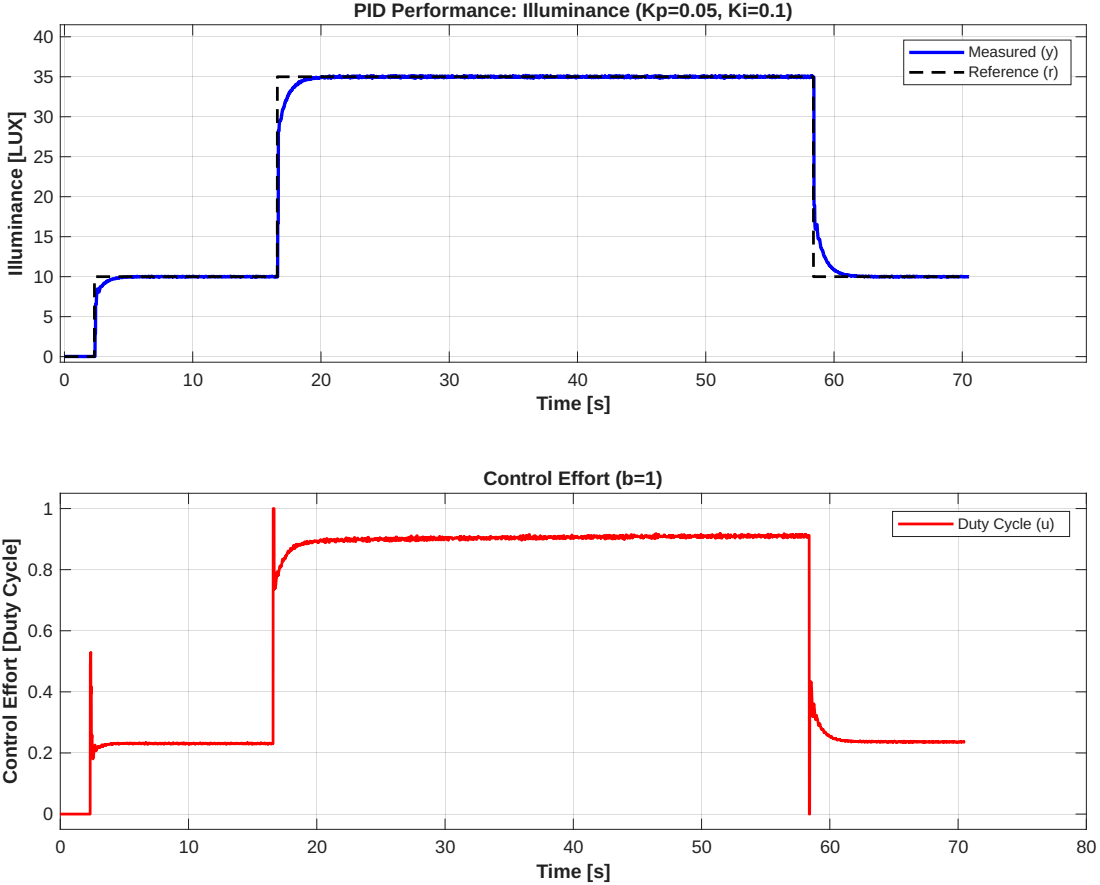
[picture p46: page 1]
Illuminance [LUX]; cle

Control Effort [Duty Cycle]
