matosmarco/SCDTR-Project/Fase1/Data_treatment/Images/kp005_ki01_b05.pdf

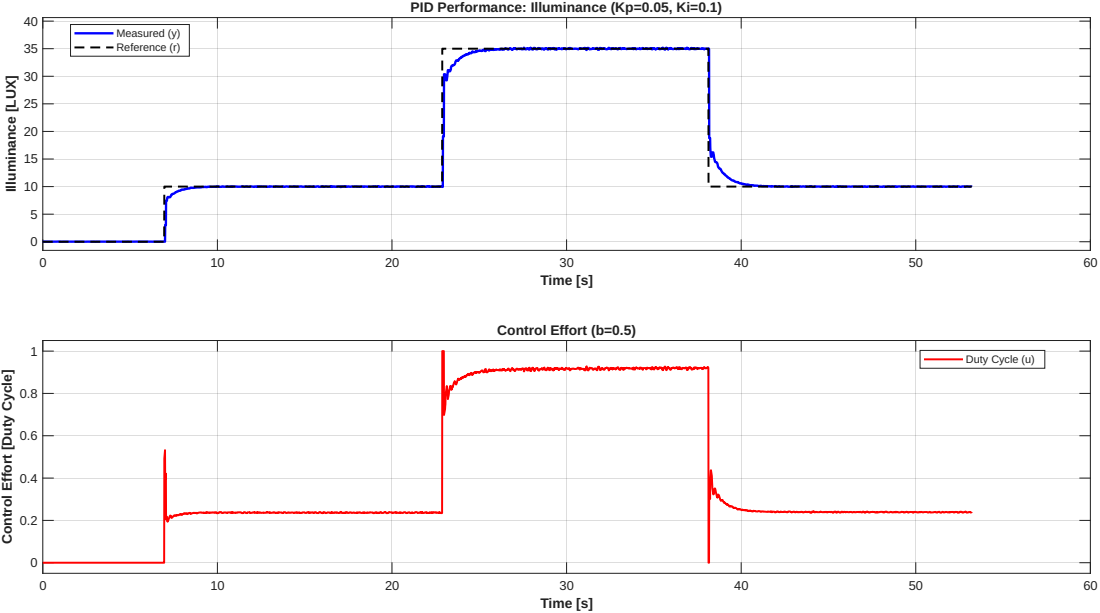
[picture p47: page 1]
Illuminance [LUX]; cle

Control Effort [Duty Cycle]
