matosmarco/SCDTR-Project/Fase1/Data_treatment/Images/kp005_ki01_b07.pdf

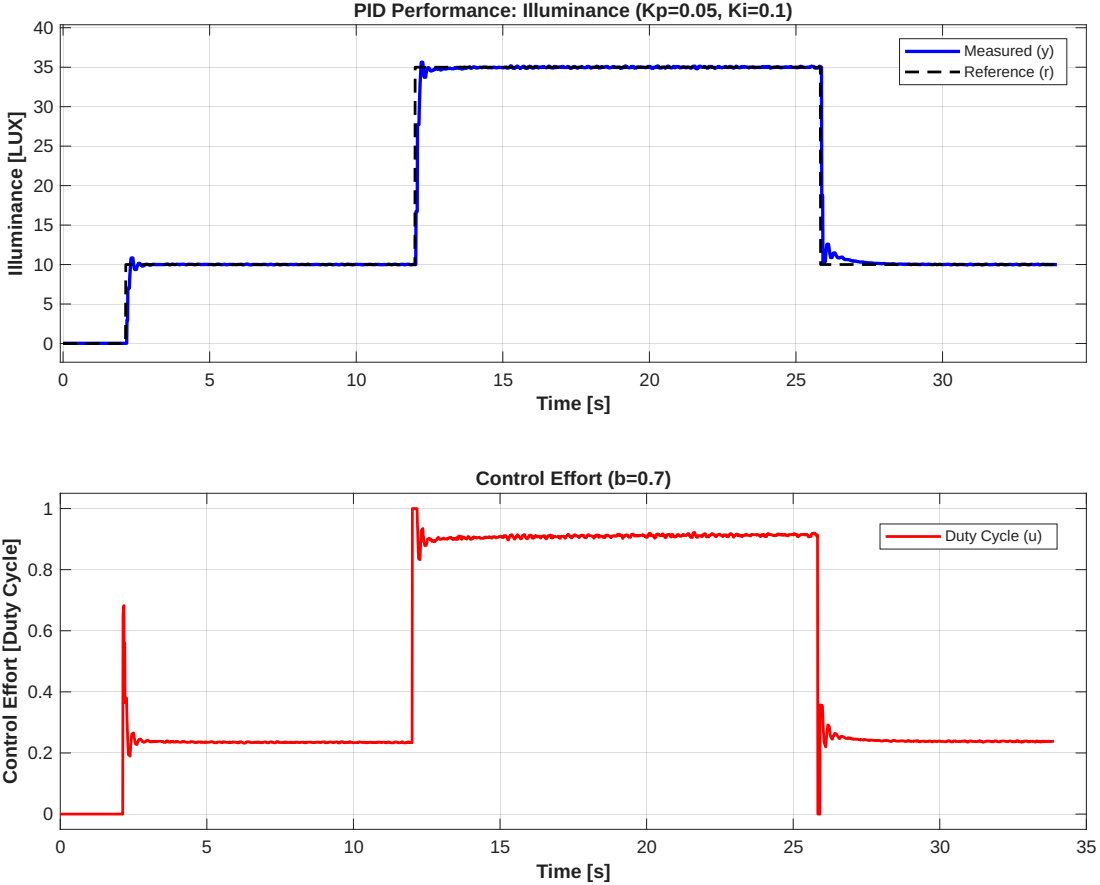
[picture p48: page 1]
Illuminance [LUX]; cle

M e a s u r e d ( y )
R e f e r e n c e ( r )

Control Effort [Duty Cycle]
