matosmarco/SCDTR-Project/Fase1/Data_treatment/Images/kp005_ki01_b09.pdf

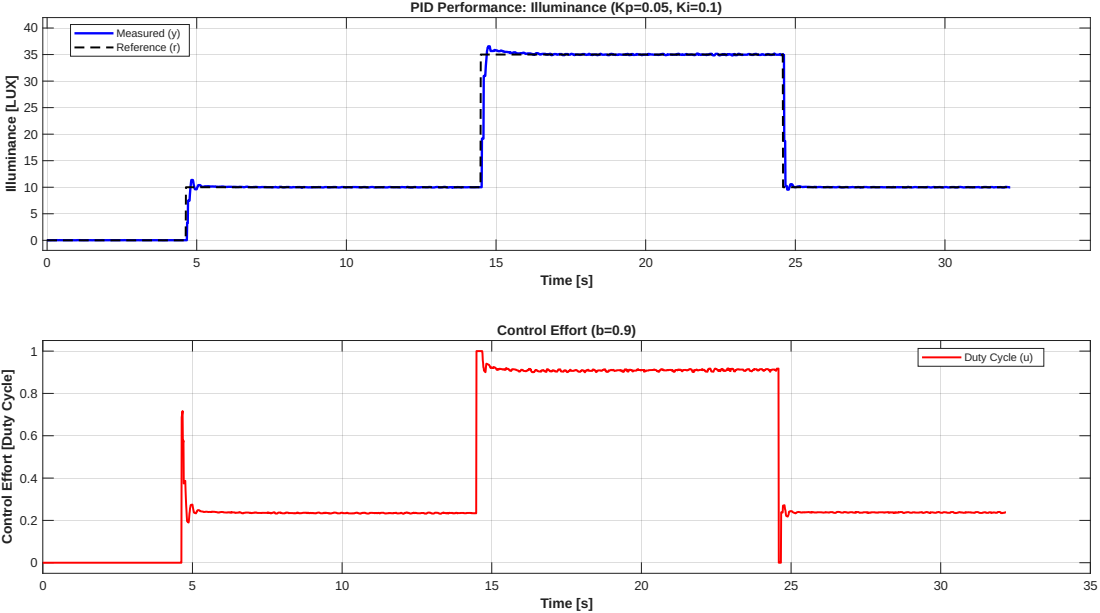
[picture p49: page 1]
Illuminance [LUX]; cle

Control Effort [Duty Cycle]
