matosmarco/SCDTR-Project/Fase1/Data_treatment/Images/metrics_20lux_reference.pdf

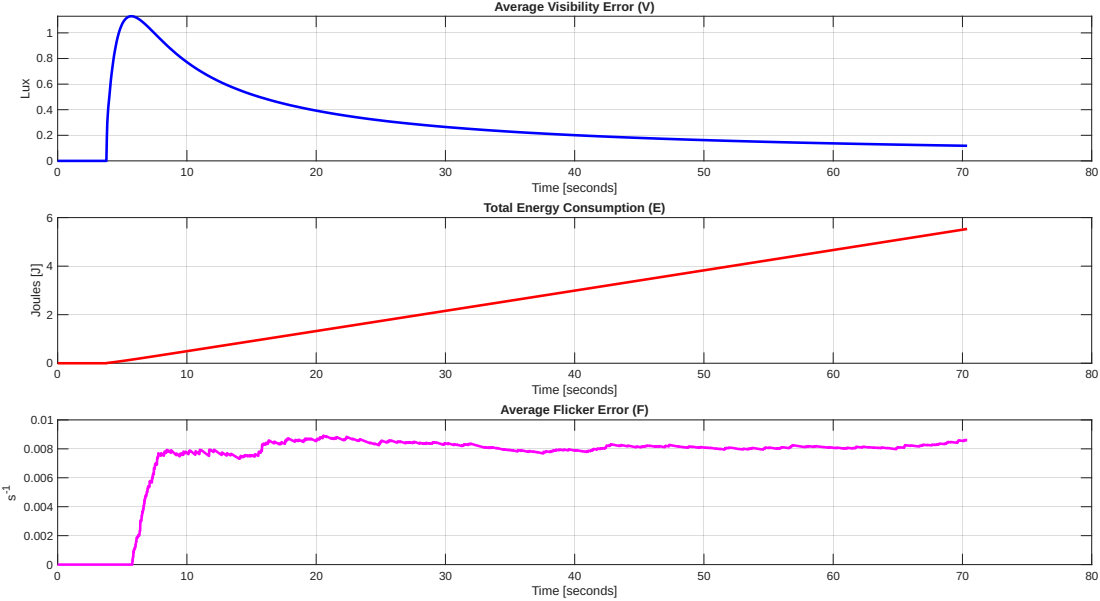
[picture p50: page 1]
Tim; Lux; Joules [J]
