matosmarco/SCDTR-Project/Fase1/Data_treatment/Images/no_antiwindup.pdf

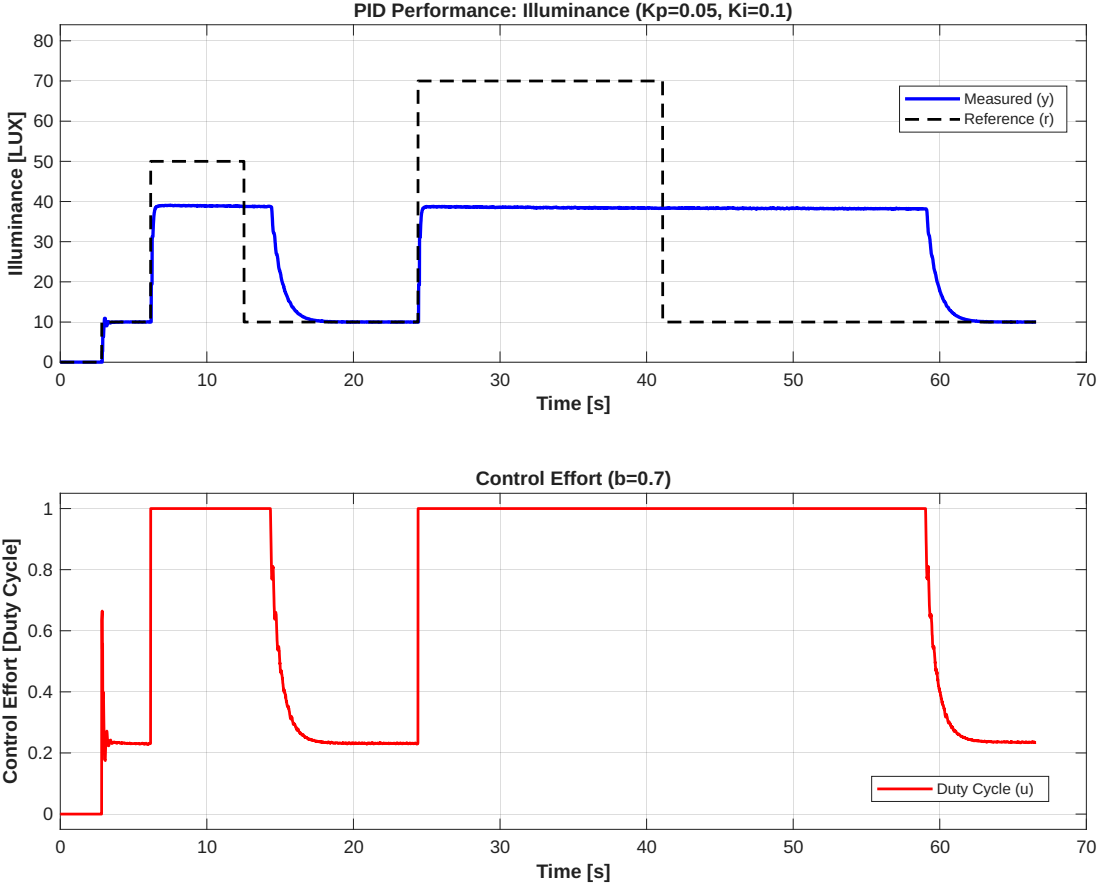
[picture p51: page 1]
Illuminance [LUX]; cle

Control Effort [Duty Cycle]
