matosmarco/SCDTR-Project/Fase1/Data_treatment/Images/vis_error_antiwindup.pdf

## Visibility Error Analysis

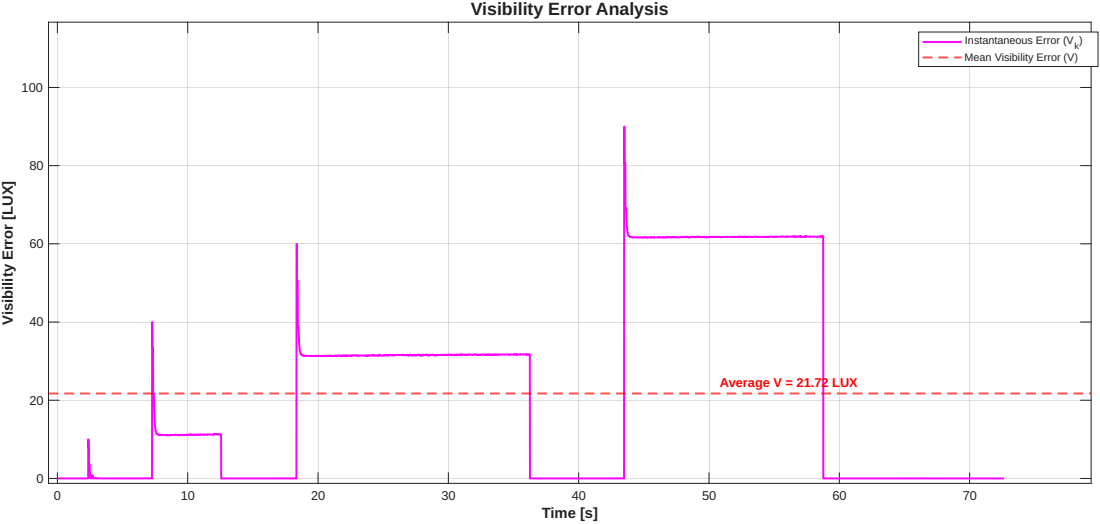
[picture p52: page 1]
Time [s]; Visibility; Error [L; Average V = 21.72 LUX

Instantaneous Error (Vk
Mean Visibility Error (V)
