matosmarco/SCDTR-Project/Fase1/Data_treatment/Images/vis_error_kp001.pdf

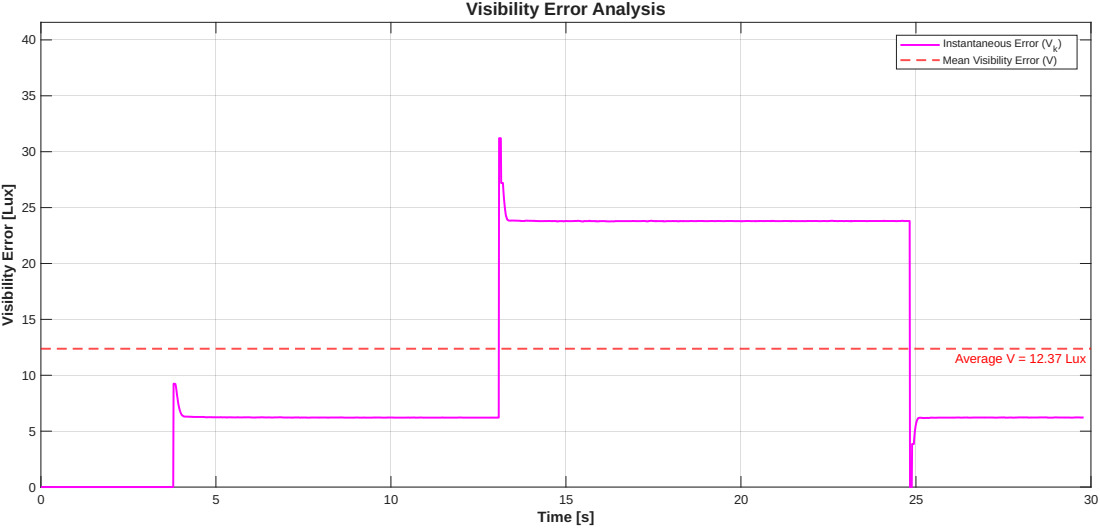
[picture p53: page 1]

x Instantaneous Error (Vk) Mean Visibility Error (V)

Visibility Error [Lux]
