matosmarco/SCDTR-Project/Fase1/Data_treatment/Images/vis_error_kp005.pdf

V

i

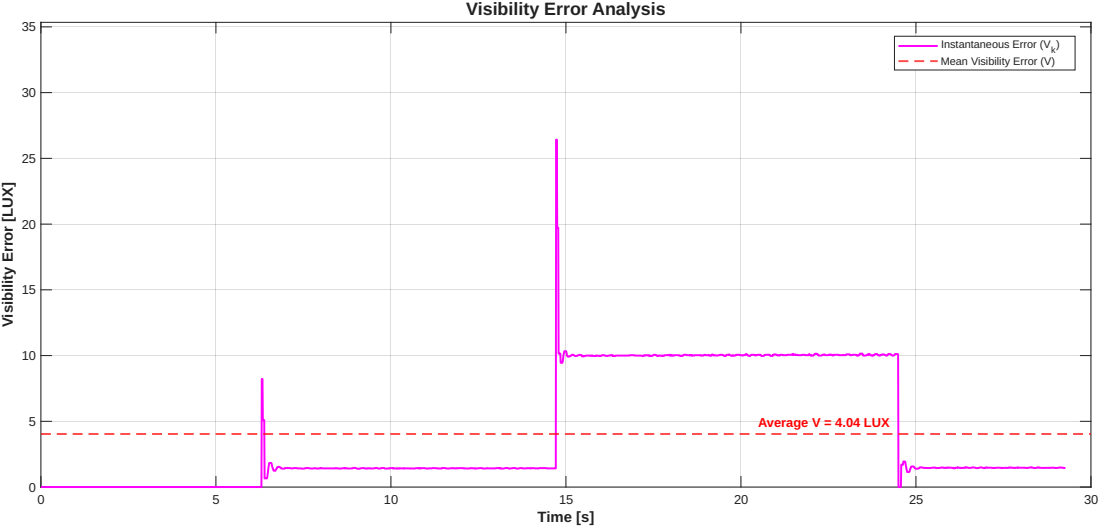
[picture p54: page 1]
Visibilit

Visibility Error [LUX]
