matosmarco/SCDTR-Project/Fase1/Data_treatment/Images/vis_error_kp005_ki001.pdf

V

i

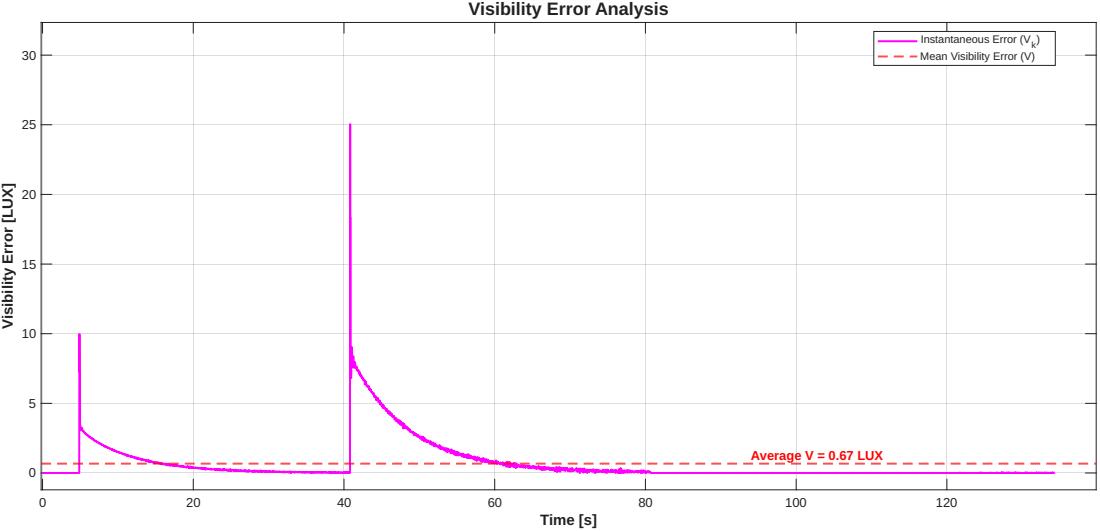
[picture p55: page 1]
Visibilit

Visibility Error [LUX]
