matosmarco/SCDTR-Project/Fase1/Data_treatment/Images/vis_error_kp005_ki005.pdf

V

i

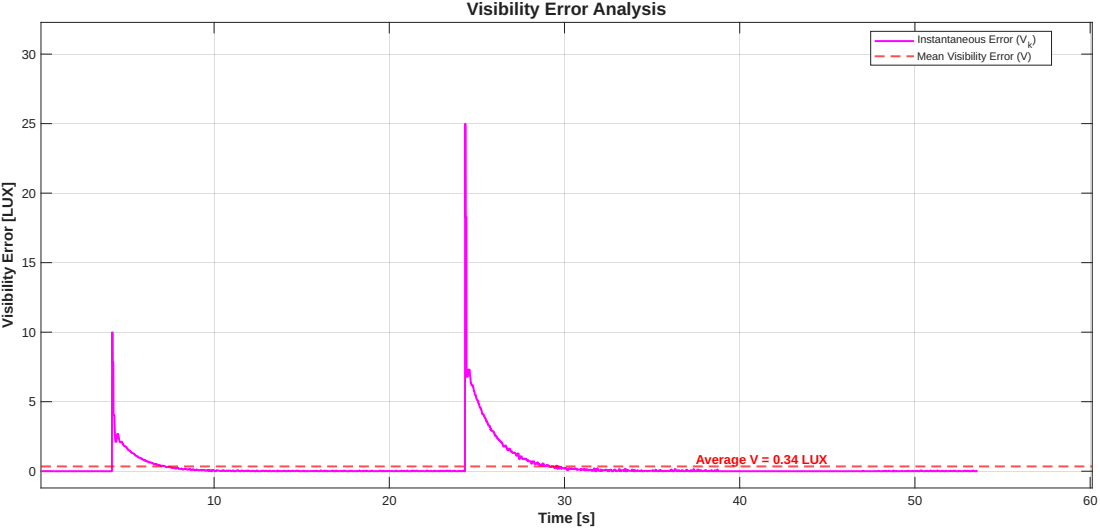
[picture p56: page 1]
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

Visibility Error [LUX]
