matosmarco/SCDTR-Project/Fase1/Data_treatment/Images/vis_error_kp005_ki01_b05.pdf

V

i

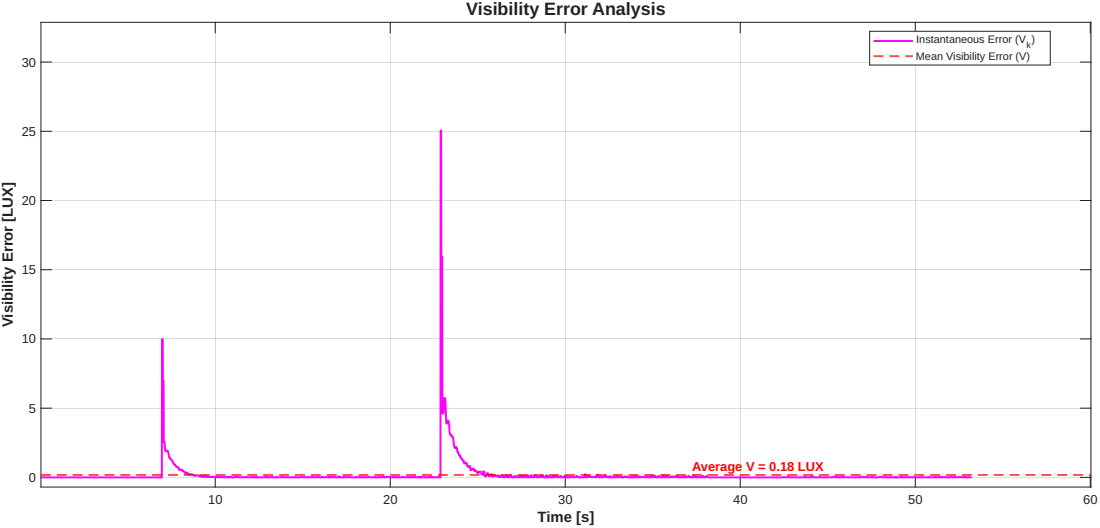
[picture p58: page 1]
Visibilit

Visibility Error [LUX]
