matosmarco/SCDTR-Project/Fase1/Data_treatment/Images/vis_error_kp005_ki01_b07.pdf

V

i

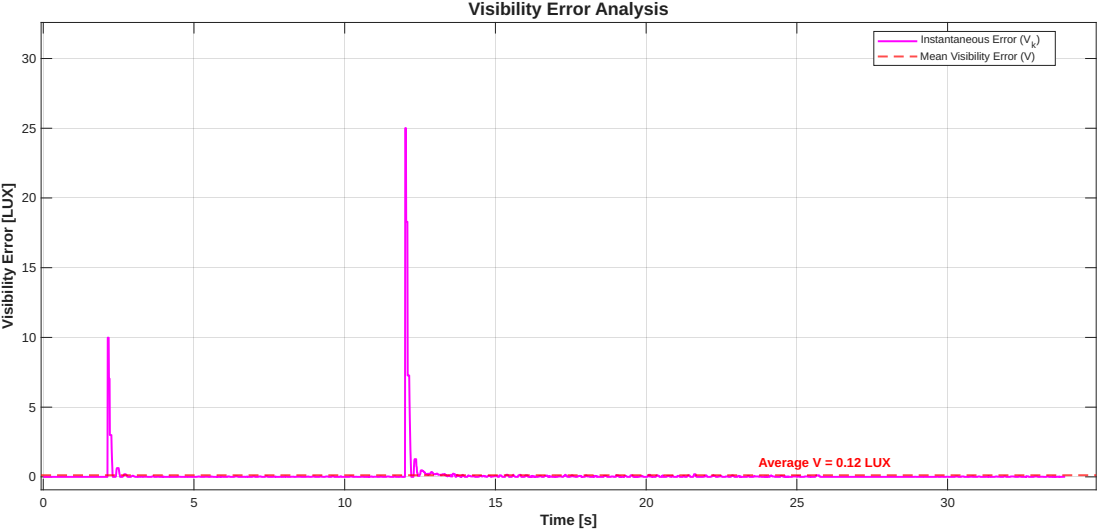
[picture p59: page 1]
Visibilit

Visibility Error [LUX]
