matosmarco/SCDTR-Project/Fase1/Data_treatment/Images/vis_error_kp005_ki01_ffon.pdf

## Visibility Error Analysis

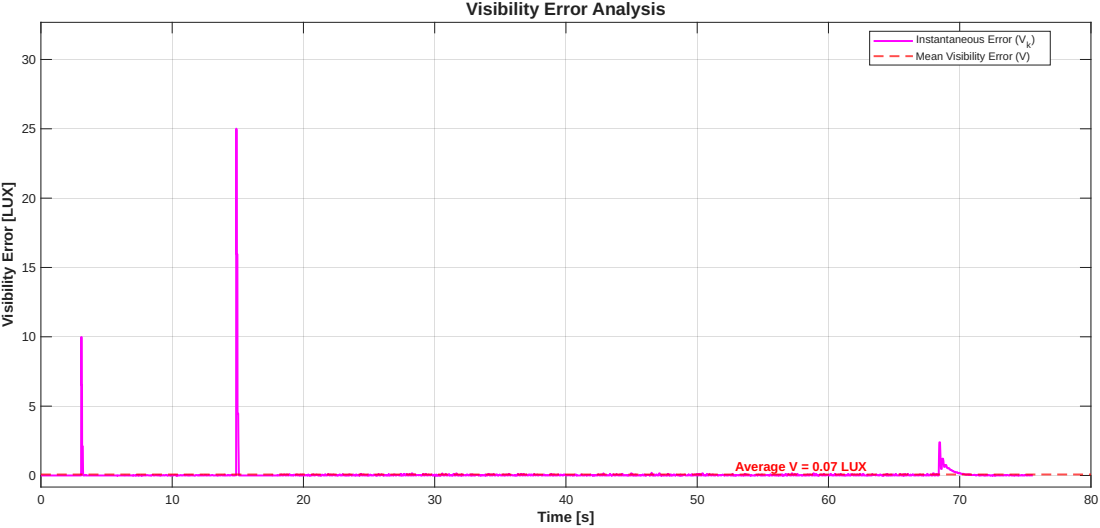
[picture p61: page 1]
Time [s]; Visibility; Error [L; Average V = 0.07 LUX

Instantaneous Error (Vk
Mean Visibility Error (V)
