matosmarco/SCDTR-Project/Fase1/Data_treatment/Images/vis_error_kp005_only.pdf

## Visibility Error Analysis

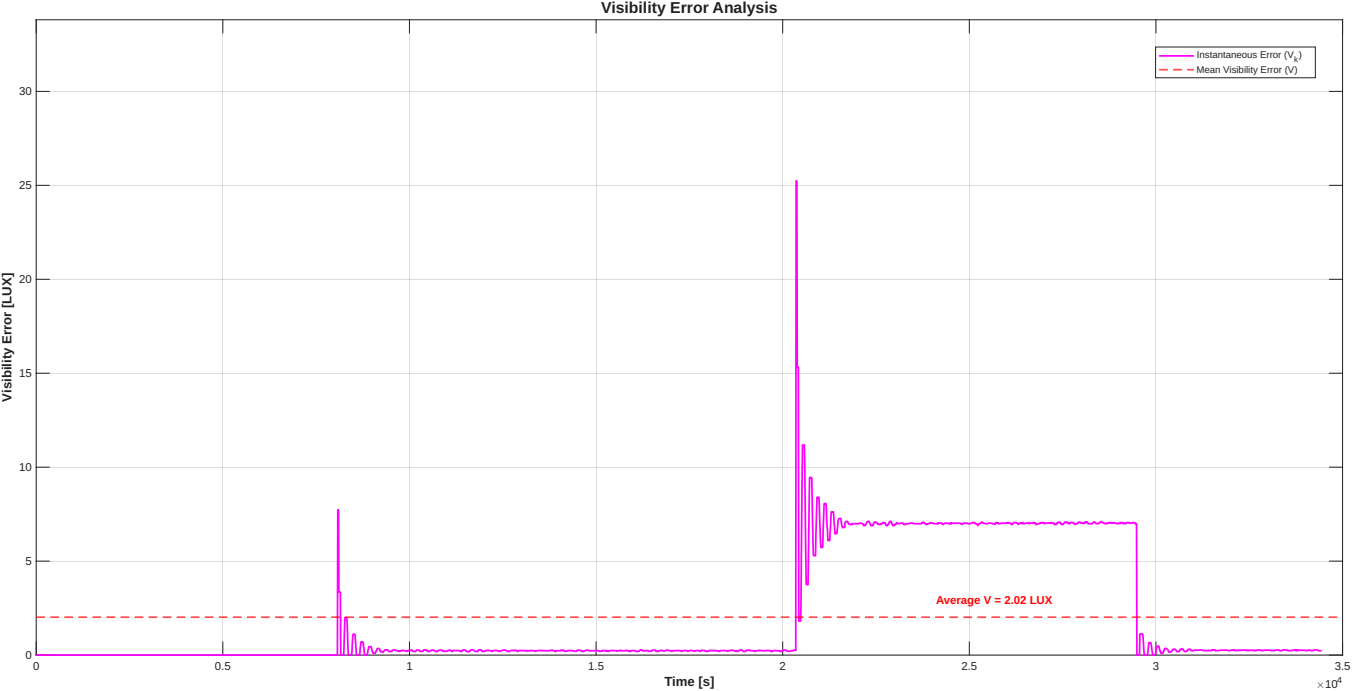
[picture p62: page 1]
Time [s]; Visibility; Error [L; Average V = 2.02 LUX

Instantaneous Error (Vk
Mean Visibility Error (V)
