matosmarco/SCDTR-Project/Fase1/Data_treatment/Images/vis_error_no_antiwindup.pdf

V

i

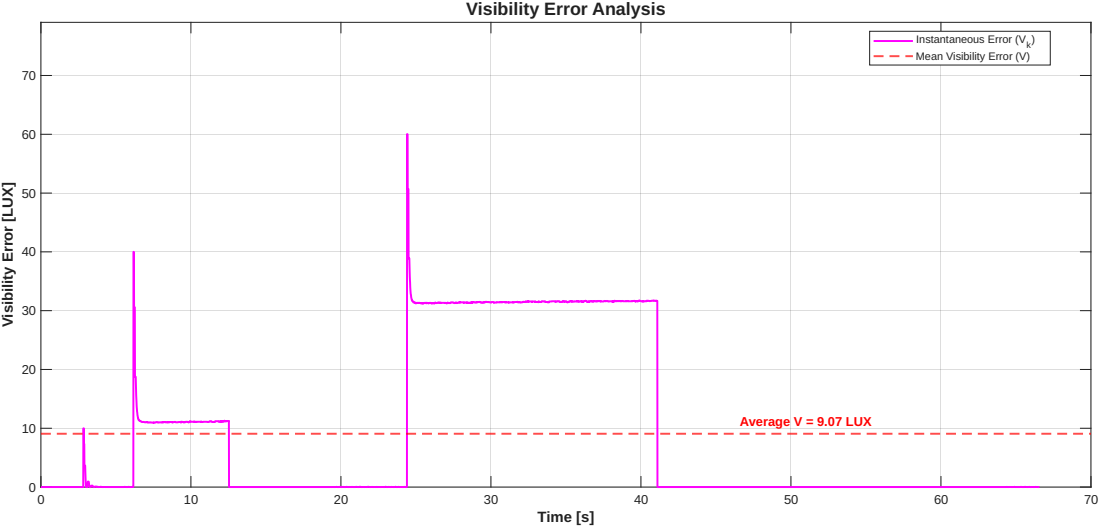
[picture p63: page 1]
Visibilit

Visibility Error [LUX]
