matosmarco/SCDTR-Project/Dual/fase2/network.cpp

#include "network.h"
#include "command.h"
#include "config.h"
#include "mcp2515.h"
#include "calibrationMatrix.h"
#include "calibrationFSM.h"
#include "metrics.h"
#include "box.h"
#include "led.h"
#include "ldr.h"
#include "luminaire.h"
#include "pid.h" 
#include <FreeRTOS.h>
#include <queue.h>
#include <task.h>
#include "admm.h"
// Variables declared in fase2.ino
extern String inputBuffer;
extern LED led;
extern LDR ldr;
extern Box box;
extern Metrics metrics;
extern Luminaire luminaire;
extern pid pid; 

// System variables and RTOS variables
extern uint8_t node_address;
extern float global_energy_cost;
extern QueueHandle_t canTxQueue;
extern QueueHandle_t canRxQueue;

// Calibration
extern CalibrationMatrix myMatrix;
extern CalibrationFSM* fsm;
extern TaskHandle_t calibTaskHandle;

// MCP2515 CAN Bus
extern MCP2515 can0;
extern struct can_frame canMsgTx, canMsgRx;
extern MCP2515::ERROR err;

// Network and streaming variables
extern bool net_streaming;
extern char net_stream_var;
extern uint8_t net_stream_dest;
extern bool net_sending_buffer;
extern char net_buffer_var;
extern int net_buffer_index;
extern uint8_t net_buffer_dest;


extern unsigned long last_seen_time[256];

float global_K_matrix[MAX_NODES][MAX_NODES] = {0.0f}; // Matrix to store all gains (1 to MAX_NODES)
int expected_k_elements = 0; // variable to flag the number of elements to be sent
extern DualDecomposition* dualDecomp;
extern ADMM* admmDecomp;
extern bool distributed_ctrl_active;

// Functions
void checkSerial() {
  while (Serial.available() > 0) {
    char c = Serial.read();
    if (c == '\n') {
      inputBuffer.trim();
      if (inputBuffer.length() > 0) {
          processCommand(inputBuffer, led, ldr, box, metrics, luminaire, pid);
      }
      inputBuffer = "";
    } else if (c != '\r') {
      inputBuffer += c;
    }
  }
}
void processNetworkMessages() {
  // Verify message in the Queue
  int msgCount = uxQueueMessagesWaiting(canRxQueue);
  if (msgCount == 0) return;

  // Local buffer
  ProtocolMsg_t msgBuffer[QUEUE_SIZE];
  int actualCount = 0;

  while (xQueueReceive(canRxQueue, &msgBuffer[actualCount], 0) == pdPASS) {
    actualCount++;
    if (actualCount >= QUEUE_SIZE) break; // to avoid overflow
  }

  //Insertion sort - lowest ID
  for (int i = 1; i < actualCount; i++) {
      ProtocolMsg_t key = msgBuffer[i];
      int j = i - 1;
      while (j >= 0 && msgBuffer[j].src_id > key.src_id) {
          msgBuffer[j + 1] = msgBuffer[j];
          j = j - 1;
      }
      msgBuffer[j + 1] = key;
  }

  // Processing messages by priority
  for (int i = 0; i < actualCount; i++) {
     ProtocolMsg_t msgIn = msgBuffer[i];

    // ATUALIZA O RELÓGIO (Ouvimos o nó, ele está vivo!)
    last_seen_time[msgIn.src_id] = xTaskGetTickCount() * portTICK_PERIOD_MS;

    //Dynamic management of the topology and isHere (H)('w', 'W', 'H')
    if (msgIn.cmd == 'H' || msgIn.cmd == 'w' || msgIn.cmd == 'W') {
        if (myMatrix.findNodeIndex(msgIn.src_id) == -1) {
            // É UM NÓ NOVO NA REDE!
            myMatrix.addNode(msgIn.src_id);
            Serial.printf("\n>>> TOPOLOGY: Node %d discovered!\n", msgIn.src_id);
            
            // Avisar a FSM que há um elemento novo na sala para forçar recalibração
            if (calibTaskHandle != NULL) {
                xTaskNotify(calibTaskHandle, EVENT_NETWORK_CHANGE, eSetBits);
            }
        }
        
        // Se ele mandou um WakeUp ('w'), respondemos com 'W' para ele saber que nós existimos
        if (msgIn.cmd == 'w') {
            ProtocolMsg_t replyMsg = {node_address, msgIn.src_id, 'W', ' ', 0.0f};
            xQueueSend(canTxQueue, &replyMsg, 0);
        }
    }
    // Passive calibration and token ring ('c')
    else if (msgIn.cmd == 'c') {
        if (msgIn.subcmd == '1' && msgIn.src_id != node_address) {
            vTaskDelay(pdMS_TO_TICKS(2000));
            float y_total = ldr.readLux();
            float d_k = box.fixed_background(ldr); 
            float k_ij = y_total - d_k;
            Serial.printf(">>> CALIB DEBUG | Lendo LED do No %d | y_total: %.2f | d_k: %.2f | K resultante: %.4f\n", msgIn.src_id, y_total, d_k, k_ij);
            if (k_ij < 0) k_ij = 0; 
            
            myMatrix.updateGain(msgIn.src_id, k_ij);
            Serial.printf("Measured cross-coupling gain from node %d: %.4f\n", msgIn.src_id, k_ij);
        } 
        else if (msgIn.subcmd == '0' && msgIn.src_id != node_address) {
            if (calibTaskHandle != NULL) {
                vTaskDelay(pdMS_TO_TICKS(2000));
                xTaskNotify(calibTaskHandle, EVENT_TOKEN_DONE, eSetBits);
            }
        }
    }

    // Distributed control- exchange values of k_ij
    else if (msgIn.cmd == 'K') {
        uint8_t col_id = (uint8_t)msgIn.subcmd;
        float gain_value = msgIn.value;
            
        Serial.printf("K_received -> Line: %d | Column: %d | Value: %.4f\n", msgIn.src_id, col_id, gain_value);
        
        // CORREÇÃO: Converter os IDs (ex: 132) para índices seguros da matriz (ex: 0, 1...)
        int row_idx = myMatrix.findNodeIndex(msgIn.src_id);
        int col_idx = myMatrix.findNodeIndex(col_id);
        
        if (row_idx != -1 && col_idx != -1) { 
            global_K_matrix[row_idx][col_idx] = gain_value;
        }        
     }


    // General commands of the network
    else if (msgIn.cmd == 'R') {    
      metrics.reset();
      box.calibrate_background(led, ldr);
      box.identify_static_gain(led, ldr);
      Serial.printf("Node %d restarted via Broadcast!\n", node_address);
    }
    else if (msgIn.cmd == 'r') {
        if (msgIn.value >= 0.0f) {
            luminaire.reference = msgIn.value;
            Serial.printf("Network: Reference changed to %.2f by Node %d\n", msgIn.value, msgIn.src_id);
        }
    }
    else if (msgIn.cmd == 'u') {
        if (msgIn.value >= 0.0f && msgIn.value <= 1.0f) {
            luminaire.current_u = msgIn.value;
            led.setDuty(msgIn.value);
            Serial.printf("Network: Duty cycle changed to %.2f by Node %d\n", msgIn.value, msgIn.src_id);
        }
    }
    else if (msgIn.cmd == 'f') {
        luminaire.feedback_on = (msgIn.value > 0.5f);
    }
    // --- TURN ON/OFF DISTRIBUTED CONTROLLER REMOTELY ---
    else if (msgIn.cmd == 'X') {
        // If the value is greater than 0.5, turn on. Otherwise, turn off.
        distributed_ctrl_active = (msgIn.value > 0.5f);
        
        if (distributed_ctrl_active) {
            Serial.printf("Network: Dual Decomposition ENABLED by Node %d\n", msgIn.src_id);
        } else {
            Serial.printf("Network: Dual Decomposition DISABLED by Node %d\n", msgIn.src_id);
        }
    }
    // ---------------------------------------------------
    else if (msgIn.cmd == 'o') {
      char occ_state = (char)msgIn.value;
      if (occ_state == 'o') { luminaire.state = LuminaireState::OFF; luminaire.reference = 0; } 
      else if (occ_state == 'l') { luminaire.state = LuminaireState::LOW; luminaire.reference = 15; } 
      else if (occ_state == 'h') { luminaire.state = LuminaireState::HIGH; luminaire.reference = 30; }
    }
    else if (msgIn.cmd == 'U') luminaire.low_bound = msgIn.value;
    else if (msgIn.cmd == 'O') luminaire.high_bound = msgIn.value;  
    else if (msgIn.cmd == 'C') global_energy_cost = msgIn.value;

    // E. GET REQUESTS ('g') & ANSWERS ('A')
    else if (msgIn.cmd == 'g') {
      
      // -- RESPOSTA AO PEDIDO DE VETOR K ('k') --
      if (msgIn.subcmd == 'k') {
          int n = myMatrix.getNumNodes(); 
          
          // 1. Envia marcador de INÍCIO ('S') COM O TAMANHO DO VETOR (n)
          //ProtocolMsg_t startK = {node_address, msgIn.src_id, 'K', 'S', (float)n};
          //xQueueSend(canTxQueue, &startK, 0);
          
         const uint8_t* nodes = myMatrix.getNodesArray();
          for (int i = 0; i < n; i++) {
              ProtocolMsg_t replyK = {node_address, msgIn.src_id, 'K', (char)nodes[i], myMatrix.getGain(nodes[i])};
              // Tolerância de 5ms para sobreviver à rajada de mensagens!
              xQueueSend(canTxQueue, &replyK, pdMS_TO_TICKS(5));
          }
          
          // 3. Envia marcador de FIM ('E')
          //ProtocolMsg_t endK = {node_address, msgIn.src_id, 'K', 'E', 0.0f};
          //xQueueSend(canTxQueue, &endK, 0);
      } 
      // -- RESTANTES COMANDOS GERAIS ('y', 'u', 'r', etc) --
      else {
          ProtocolMsg_t response;
          response.dest_id = msgIn.src_id; 
          response.src_id = node_address;
          response.cmd = 'A';              
          response.subcmd = msgIn.subcmd;

          if (msgIn.subcmd == 'y') response.value = ldr.readLux();
          else if (msgIn.subcmd == 'u') response.value = luminaire.current_u;
          else if (msgIn.subcmd == 'r') response.value = luminaire.reference;
          else if (msgIn.subcmd == 'v') response.value = ldr.readVoltage();
          else if (msgIn.subcmd == 'd') response.value = box.get_background(ldr);
          else if (msgIn.subcmd == 'p') response.value = metrics.getInstantaneousPower(luminaire.current_u);
          else if (msgIn.subcmd == 't') response.value = (xTaskGetTickCount() * portTICK_PERIOD_MS) / 1000.0f;          
          else if (msgIn.subcmd == 'E') response.value = metrics.energy;
          else if (msgIn.subcmd == 'V') response.value = metrics.getAverageVisibility();
          else if (msgIn.subcmd == 'F') response.value = metrics.flicker; 
          else if (msgIn.subcmd == 'U') response.value = luminaire.low_bound;
          else if (msgIn.subcmd == 'O') response.value = luminaire.high_bound;
          else if (msgIn.subcmd == 'C') response.value = global_energy_cost;
          else if (msgIn.subcmd == 'L') {
              if (luminaire.state == LuminaireState::HIGH) response.value = luminaire.high_bound;
              else response.value = luminaire.low_bound; 
          }
          else if (msgIn.subcmd == 'o') {
              char s = 'o';
              if (luminaire.state == LuminaireState::LOW) s = 'l';
              else if (luminaire.state == LuminaireState::HIGH) s = 'h';
              response.value = (float)s;
          }

          xQueueSend(canTxQueue, &response, 0);
      }
    }
    
    // PROCESSAMENTO DE RESPOSTAS NORMAIS ('A')
    else if (msgIn.cmd == 'A') {
      Serial.print("Received final answer: ");
      if (msgIn.subcmd == 'o') {
          Serial.printf("%c %d %c", msgIn.subcmd, msgIn.src_id, (char)msgIn.value);
      } else {
          Serial.printf("%c %d %.4f", msgIn.subcmd, msgIn.src_id, msgIn.value);
      }
      Serial.println("\n==================================\n");
    }

    // ---------------------------------------------------------
    // F. STREAMING E METRICS BUFFER ('s', 'S', 'D', 'b', 'B')
    // ---------------------------------------------------------
    else if (msgIn.cmd == 's') { 
        net_streaming = true;
        net_stream_var = msgIn.subcmd;
        net_stream_dest = msgIn.src_id;
    }
    else if (msgIn.cmd == 'S') { 
        net_streaming = false;
    }
  // ---------------------------------------------------------
    // DISTRIBUTED OPTIMIZATION & NETWORK STREAMING
    // ---------------------------------------------------------
    else if (msgIn.cmd == 'D') { 
        // 1. Is it from ADMM? (Sent via Broadcast to 255)
        if (msgIn.dest_id == 255) {
            // Store in memory for calculations. NO PRINTING! (Total silence)
            if (dualDecomp != nullptr) {
                dualDecomp->updateOtherU(msgIn.src_id, msgIn.value, myMatrix);
            }
        }
        // 2. Is it Remote Streaming on demand? (Sent DIRECTLY to me)
        else if (msgIn.dest_id == node_address) {
            // Here we do the print requested by the 's' command
            Serial.printf("s %c %d %.4f %lu\n", msgIn.subcmd, msgIn.src_id, msgIn.value, (unsigned long)(xTaskGetTickCount() * portTICK_PERIOD_MS));    
        }
    }
    
    // RECEPTION OF PRICES
    else if (msgIn.cmd == 'P') {
        // Prices are private. Store in memory without printing.
        if (dualDecomp != nullptr && msgIn.dest_id == node_address) {
            dualDecomp->updateOtherPrice(msgIn.src_id, msgIn.value, myMatrix);
        }
    }
    // =========================================================
    // RECEÇÃO DE DADOS ADMM ('M')  <--- ADICIONA ESTE BLOCO TODO
    // =========================================================
    else if (msgIn.cmd == 'M') {
        if (msgIn.dest_id == 255 && admmDecomp != nullptr) {
            // O subcmd contém o ID original a que este valor percentual se refere
            int src_idx = myMatrix.findNodeIndex(msgIn.src_id);
            int target_idx = myMatrix.findNodeIndex((uint8_t)msgIn.subcmd);
            
            admmDecomp->update_network_u_element(src_idx, target_idx, msgIn.value);
        }
    }
    // =========================================================
    else if (msgIn.cmd == 'b') { 
        if (msgIn.value == -1.0f) {        
            Serial.printf("b %c %d ", msgIn.subcmd, msgIn.src_id);
        } else if (msgIn.value == -2.0f) { 
            Serial.println();
        } else {                           
            net_sending_buffer = true;
            net_buffer_var = msgIn.subcmd;
            net_buffer_index = 0;
            net_buffer_dest = msgIn.src_id;
            
            ProtocolMsg_t startMsg = {node_address, msgIn.src_id, 'b', msgIn.subcmd, -1.0f};
            xQueueSend(canTxQueue, &startMsg, 0);
        }
    }
    else if (msgIn.cmd == 'B') { 
        Serial.printf("%.2f,", msgIn.value);
    }
  } 
}
// CAN communication functions - core 1
// CAN communication functions - core 1
void sendMessage() {
  ProtocolMsg_t msgOut;
  
  // USAR PEEK: Apenas "espreita" a mensagem sem a tirar da fila
  if (xQueuePeek(canTxQueue, &msgOut, 0) == pdPASS) {
    canMsgTx.can_id = node_address;
    canMsgTx.can_dlc = 8; 
    
    canMsgTx.data[0] = msgOut.src_id;   // Sender
    canMsgTx.data[1] = msgOut.dest_id;  // Target
    canMsgTx.data[2] = msgOut.cmd;
    canMsgTx.data[3] = msgOut.subcmd;
    memcpy(&canMsgTx.data[4], &msgOut.value, sizeof(float));
    
    err = can0.sendMessage(&canMsgTx);

    if (err == MCP2515::ERROR_OK) {
        // SUCESSO! Agora sim, removemos a mensagem definitivamente da fila
        xQueueReceive(canTxQueue, &msgOut, 0);
    } 
    else if (err != MCP2515::ERROR_ALLTXBUSY) {
        // Erro fatal (cabo desligado, etc). Removemos para não bloquear a fila toda.
        xQueueReceive(canTxQueue, &msgOut, 0);
        bool is_alone = (myMatrix.getNumNodes() <= 1);
        if (msgOut.cmd != 'W' && !is_alone) {
             Serial.printf("[CAN ERROR] Failed to send '%c'! MCP2515 Error: %d\n", msgOut.cmd, err);
        }
    }
    // Se for ALLTXBUSY, não fazemos nada! A mensagem fica na fila para tentar no próximo ciclo.
  }
}
void readMessage() {
  while((err = can0.readMessage(&canMsgRx)) == MCP2515::ERROR_OK){
    
    uint8_t sender = canMsgRx.data[0];
    uint8_t target_dest = canMsgRx.data[1];
    char cmd_received = canMsgRx.data[2]; 
    
    // ANTI-SPAM FILTER (NON-BLOCKING - FREERTOS)
    static unsigned long last_rx_print = 0;
    unsigned long current_time = (unsigned long)(xTaskGetTickCount() * portTICK_PERIOD_MS);

    // Only allows printing every 1000ms (1 second)
    if (current_time - last_rx_print > 1000) {
        // And ignores Heartbeat ('H') messages which are constant spam
        if (cmd_received != 'H') { 
            Serial.printf("[CAN RX] Physically received a message from node %d to node %d\n", sender, target_dest);
        }
        last_rx_print = current_time;
    }

    // Only process if the message is for our node or Broadcast (255)
    if (target_dest == node_address || target_dest == 255) {
      ProtocolMsg_t msgIn;
      msgIn.src_id  = canMsgRx.data[0];
      msgIn.dest_id = canMsgRx.data[1];
      msgIn.cmd     = canMsgRx.data[2];
      msgIn.subcmd  = canMsgRx.data[3];
      memcpy(&msgIn.value, &canMsgRx.data[4], sizeof(float));
      
      xQueueSend(canRxQueue, &msgIn, 0);
    }
  }
}
// CAN error handling - core 1
void handleCANErrors() {
    uint8_t eflg = can0.getErrorFlags();
    static uint8_t last_eflg = 0; 

    // 1. Limpeza de Overflow (Isto é rápido e não bloqueia)
    if (eflg & (MCP2515::EFLG_RX0OVR | MCP2515::EFLG_RX1OVR)) {
        can0.clearRXnOVRFlags(); 
        can0.clearInterrupts();  
        if (!(last_eflg & (MCP2515::EFLG_RX0OVR | MCP2515::EFLG_RX1OVR))) {
            Serial.println("\n[RECUPERAÇÃO] Flags de Overflow limpas. Rede restaurada!");
        }
    }

    // 2. Diagnósticos de Série (Apenas avisa uma vez quando o estado muda)
    if (eflg != last_eflg) {
        last_eflg = eflg; 
        if (eflg != 0 && myMatrix.getNumNodes() != 1) {
            Serial.println("\n[CAN DIAGNOSTICS] Alteração no estado físico do Bus:");
            if (eflg & MCP2515::EFLG_TXBO)   Serial.println(" -> ERRO CRÍTICO: Bus-Off (Muitas falhas de TX)!"); 
            if (eflg & MCP2515::EFLG_TXEP)   Serial.println(" -> AVISO: TX Error-Passive (TEC >= 128)");
            if (eflg & MCP2515::EFLG_RXEP)   Serial.println(" -> AVISO: RX Error-Passive (REC >= 128)");
            Serial.println("------------------------------------------------");
            can0.clearERRIF();
            can0.clearMERR();
        } else if (myMatrix.getNumNodes() == 1) {
            return;
        } else {
            Serial.println("\n[CAN DIAGNOSTICS] A rede estabilizou. Erros físicos resolvidos.");
        }
    }

    // 3. Recuperação de Bus-Off com COOLDOWN (Para evitar o Reset Loop fatal)
    if (eflg & MCP2515::EFLG_TXBO) {
        static unsigned long last_reset_time = 0;
        unsigned long current_time = millis();
        
        // Só permite tentar fazer reset de 2 em 2 segundos!
        if (current_time - last_reset_time > 2000) {
            Serial.println("\n[RECUPERAÇÃO] A reiniciar o controlador MCP2515 para sair de Bus-Off...");
            last_reset_time = current_time;
            
            // Tenta reiniciar
            can0.reset();
            can0.setBitrate(CAN_1000KBPS);
            can0.setNormalMode();
            
            // REMOVIDO: last_eflg = 0; (Isto causava spam infinito no Serial)
            // REMOVIDO: vTaskDelay(10); (Causava bloqueio constante)
        }
    }
}
