matosmarco/SCDTR-Project/Dual/fase2/command.h

#ifndef COMMAND_H
#define COMMAND_H

#include <Arduino.h>
#include "led.h"
#include "ldr.h"
#include "box.h"
#include "metrics.h"
#include "luminaire.h"
#include "pid.h"
// Global function to process commands
void processCommand(String cmd, LED& led, LDR& ldr, Box& box, Metrics& metrics, Luminaire& luminaire, pid& pid);

#endif
