matosmarco/SCDTR-Project/(commit log)

2026-03-10 Commands and PID from the slides
2026-03-11 PID working. Missing parameter tuning
    [command.cpp, main.ino, pid.cpp, pid.h]
2026-03-16 PID corrected and some experiments on the PID parameters
    [box.cpp, box.h, command.cpp, ldr.cpp, luminaire.h, main.ino, pid.cpp, pid.h]
2026-03-17 Graphs completed, C++ code stage 1 finished
2026-03-19 Final graphs for stage 1
    [b02.csv, b05.csv, b07.csv, b10.csv, kp_high.csv, kp_low.csv, kp_medium.csv, kp_with_ki_high.csv]
2026-03-20 Delivered report
    [b02.csv, b05.csv, b07.csv, b10.csv, kp_high.csv, kp_low.csv, kp_medium.csv, kp_with_ki_high.csv]
2026-04-05 Primeiras alterações fase2
    [b02.csv, b05.csv, b07.csv, b10.csv, kp_high.csv, kp_low.csv, kp_medium.csv, kp_with_ki_high.csv]
2026-04-07 Calibration 1st version done
